Nikolaibonderup/P4---El-tek/Billeder/print.jpg

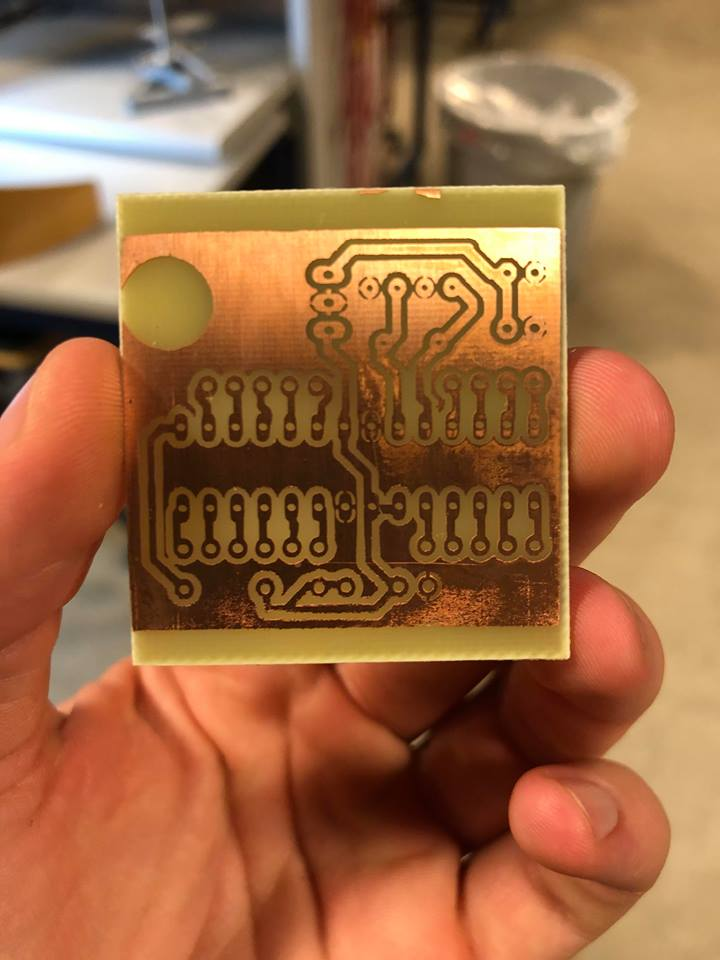
Billeder/print.jpg
