Nikolaibonderup/P4---El-tek/Billeder/printpapir.jpg

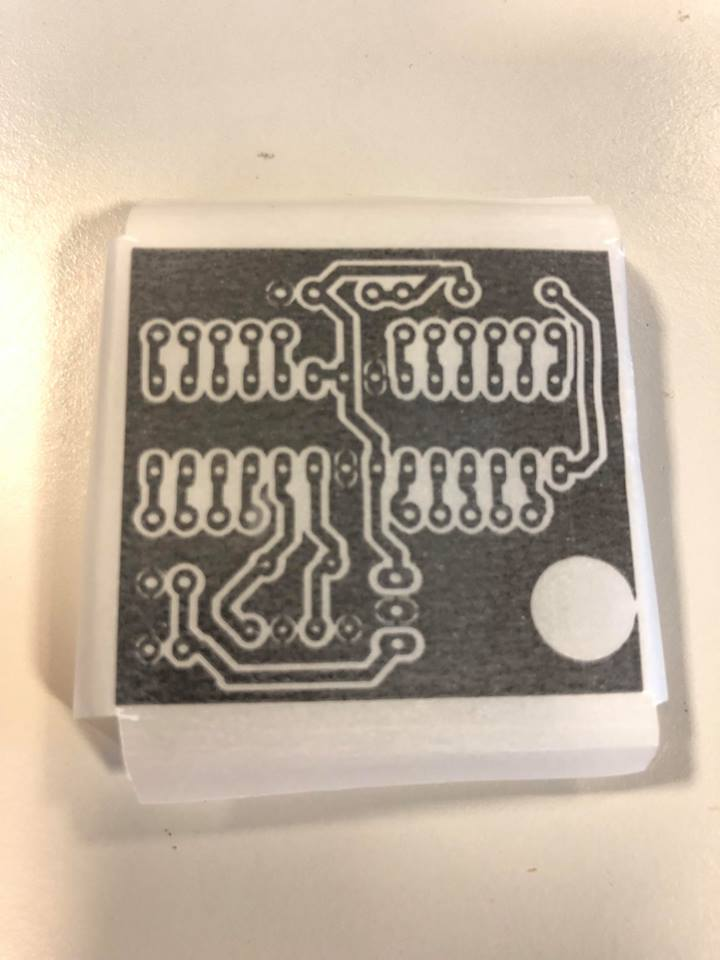
Billeder/printpapir.jpg
