Nikolaibonderup/P4---El-tek/README.md

# P4---El-tek
Projekt 4 i el teknik

#Git arkiv til p4 projekt
Dette er et git arkiv til P4---El-tek
