Nikolaibonderup/P4---El-tek/Tekst/Problemformulering.tex

%Dokument til Projektformulering
\subsection{Projektformulering}

Hvordan kan vi bygge et produkt som opfylder de faglige mål for projektet og som bygger på fysikteoretiske koncepter?\\

Til problemformuleringen kan flere underspørgsmål udformes:
\begin{itemize}
\item Hvordan kan et mikrocontroller print fabrikeres?
\item Hvordan vil man integrere datakommunikation i produktet? 
\item Hvilke former for sensorer kan bruges i løsningen og til den videnskabelige dokumentation?
\item Hvordan kan produktet bruges til at vise noget relevant fysikteori?
\end{itemize}
