Nikolaibonderup/P4---El-tek/Tekst/Bilag.tex

\section{Bilag}
\emph{Fysikrapport} af Nikolai Aaen Bonderup, Sebastian Lassen og Lucas Mark Rasmussen.\\[0.5cm]

\emph{Elektronik affald} af Nikolai Aaen Bonderup, Sebastian Lassen og Lucas Mark Rasmussen.\\[0.5cm]

\emph{Kode} af Nikolai Aaen Bonderup, Sebastian Lassen og Lucas Mark Rasmussen.\\[0.5cm]

\emph{Gruppekontrakt} af Nikolai Aaen Bonderup, Sebastian Lassen og Lucas Mark Rasmussen.\\[0.5cm]

\emph{Logbøger} af Nikolai Aaen Bonderup, Sebastian Lassen og Lucas Mark Rasmussen.\\[0.5cm]

\newpage
\input{Tekst/kode}
