Nikolaibonderup/P4---El-tek/Tekst/Forside1.tex

\begin{titlepage}

\newcommand{\HRule}{\rule{\linewidth}{0.5mm}} % Defines a new command for the horizontal lines, change thickness here

\center % Center everything on the page
 
%----------------------------------------------------------------------------------------
%	HEADING SECTIONS
%----------------------------------------------------------------------------------------

\textsc{\LARGE Aalborg Tekniske Gymnasium}\\[1.5cm] % Name of your university/college
\textsc{\Large P4 - El-Tek}\\[0.5cm] % Major heading such as course name
\textsc{\large El-teknik A}\\[0.5cm] % Minor heading such as course title

%----------------------------------------------------------------------------------------
%	TITLE SECTION
%----------------------------------------------------------------------------------------

\HRule \\[0.4cm]
{ \huge \bfseries En fjernstyret kanon  }\\[0.4cm] % Title of your document
\HRule \\[1.5cm]
 
%----------------------------------------------------------------------------------------
%	AUTHOR SECTION
%----------------------------------------------------------------------------------------

\begin{minipage}{0.4\textwidth}
\begin{flushleft} \large
\emph{Forfatter:}\\
Nikolai \textsc{Bonderup}\\ % Your name
Sebastian \textsc{Lassen}\\
Lucas \textsc{Rasmussen}
\end{flushleft}
\end{minipage}
~
\begin{minipage}{0.4\textwidth}
\begin{flushright} \large
\emph{Vejleder:} \\
Pia \textsc{Thomsen} \\ % Supervisor's Name
Tom \textsc{Berthelsen}\\
\end{flushright}
\end{minipage}\\[2cm]

% If you don't want a supervisor, uncomment the two lines below and remove the section above
%\Large \emph{Author:}\\
%John \textsc{Smith}\\[3cm] % Your name

%----------------------------------------------------------------------------------------
%	DATE SECTION
%----------------------------------------------------------------------------------------

{\large \today}\\[2cm] % Date, change the \today to a set date if you want to be precise

\vfill % Fill the rest of the page with whitespace

\end{titlepage}
