Nikolaibonderup/P4---El-tek/Tekst/Kildeliste.tex

\section{Litteraturliste}
\emph{Teknisk Matematik} af Preben Madsen, 4. Udgave. \\[0.5cm]
\emph{Orbit B} af Per Holck, Jens Kraaer og Birgitte Merci Lund. \\[0.5cm]
\url{http://www.matematikfysik.dk/fys/noter_tillaeg/tillaeg_det_skraa_kast_uden_luftmodstand.pdf} af \url{http://www.matematikfysik.dk}. Senest læst den 19/12/2018.\\[0.5cm]
\url{http://www.matematiksider.dk/projekter/skraakast.pdf} af \url{http://www.matematiksider.dk}. Senest læst den 19/12/2018
