Nikolaibonderup/P4---El-tek/FysikRapport.pdf

Aalborg Tekniske Gymnasium

Studieområde-projekt

Fysik A & el-teknik A

# En fjernstyret kanon & det skrå kast

### Forfatter: Nikolai Bonderup Sebastian Lassen Lucas Rasmussen

### Vejleder:

Pia Thomsen

Tom Berthelsen

### December 19, 2018

## Indholdsfortegnelse

1 Indledning | 2
2 Kravspecifikationer | 3
3 Projektanalyse | 4
4 Projektformulering | 5
5 Projektafgrænsning | 6
6 Tidsplan | 8
7 Systembeskrivelse | 9
8 Litteraturliste | 23

## 1 Indledning

Projektet ligger under studieområdet, hvilket her betyder at vi skal kombinere vores teknikfag med et af vores studieretningsfag. Vi har i gruppen valgt at bruge Fysik A, da dette virkede som det mest oplagte valg ift. bidragelse med projektrelevant teori. Projektet skal derfor også overholde forskellige krav fra SO, el-tek og fysik A, som bliver yderligere fremhævet i kravspecifikationen.

Vi har i gruppen besluttet os for at bygge en fjernstyret airsoft kanon, da dette produkt vil tilfredsstille alle de givne el-tek krav, samt at fysikteorien omkring det skrå kast kan bruges til at bestemme, hvor dets projektil vil ramme og hvor hurtigt det bevæger sig. Det kan gøres ved at måle, hvor langt kanonen skyder og hvilken vinkel løbet er peget op med, for så derefter at beregne mundingshastigheden vha. formler for det skrå kast. Dette kan så krydstjekkes med en målt projektilhastighed for, at opnå et fysikeksperiment udført med hjælp af elektriske komponenter.

## 2 Kravspecifikationer

De opstillede krav fra el-tek:

Der skal bruges en “interrupt” (HW - Kontakt, SW - Timer).

- Der skal altså i projektet bruges enten en kontakt eller timer i vores kredsløb. Det er påkrævet at denne har en relevant betydning for selve kredsløbet og ikke har en meningsløs funktion.

Der skal være et sensor input: analog til digital konvertering.

- Dette forstås som at der skal bruges en type sensor, som måler noget analogt, der derefter kan oversættes til noget digitalt vha. en mikroprocessor. Dette kunne for eksempel være en afstandssensor.

Digital til Analog konvertering.

- Dette vil ved brug af Arduino i de fleste tilfælde være at bruge et PWM signal til kontrol af et elektronisk element.

Der skal bruges datakommunikation (til pc, viserinstrument eller trådløst element).

- Dette ville være en form for input/output type af kontrol i forhold til vores produkt. Her skal gruppen kunne give en eller anden form for ordre til produktet og produktet skal så udføre en bestemt handling. Dette kunne opfyldes ved at styre kanonens vinkel med en controller vha. bluetooth.

Et print til en mikrocontroller.

- Der skal til produktet bruges et selvproduceret mikrocontrollerprint. Denne microcontroller skal kunne styre en af hovedelementerne i selve produktet for at opfylde kravet om at have en relevant funktion.

Udover de specifikke krav skal der også indrages relevant fysikteoretisk arbejde, som udmunder i afleveringen af videnskabelig dokumentation vedrørende det valgte fysikteori og el-tek produkt.

## 3 Projektanalyse

I dette projekt skal vi kombinere Fysik A og el-tek til et SO forløb. I projektet er der flere faglige mål som skal opfyldes indenfor området el-tek og fysik. Selve opgaven lyder på at gøre brug af de elementer som er at finde under kravspecifikationer. I problemanalysen skal disse elementer altså gennemgås og der skal vurderes, hvilket et af dem bliver det største “problem” at arbejde med.

Det mest udfordrende bliver at få skabt kommunikation mellem selve kanonen og et kontrolelement. Der skal være en modtager og afsender, måske endda en af hver på både kontrolmodul og kanon-modulet alt efter hvor avanceret arbejdet med denne del af projektet skal være.

Et andet udfordrende problem bliver, hvordan selve lade- og affyringsmekanismen skal hænge sammen så den kan virke ved fjernstyring. Her skal flere forskellige typer motorer styres præcist gennem bluetooth.

## 4 Projektformulering

Hvordan kan vi bygge et produkt som opfylder de faglige mål for projektet og som bygger på fysikteoretiske koncepter?

Til problemformuleringen kan flere underspørgsmål udformes:

- Hvordan kan et mikrocontroller print fabrikeres?
- Hvordan vil man integrere datakommunikation i produktet?
- Hvilke former for sensorer kan bruges i løsningen og til den videnskabelige dokumentation?
- Hvordan kan produktet bruges til at vise noget relevant fysikteori?

## 5 Projektafgrænsning

Vi har planlagt at arbejde med en kanon som skal kunne rotere 360 grader, samt have et vinkelinterval til affyring af kanonen på mindst 100 grader. Den fjernstyrede kanon skal være i stand til at modtage information fra et kontrolmodul. Dette skal ske ved brug af en bluetooth enhed eller et andet trådløst kommunikationsmodul. Der skal altså laves en mikrocontroller som kan styre kanonen gennem disse trådløse moduler ved at få kommandoer fra et kontrolmodul.

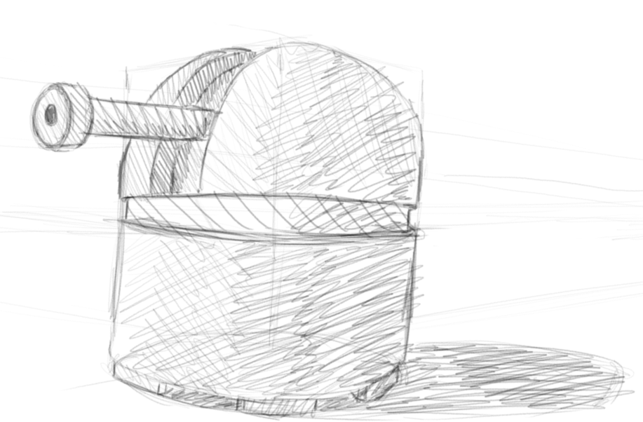
[picture p3: figure]

Fig. 1: Koncept af kanon.

Selve kanons affyringsmekanisme laves enten med en “airsoft” pneumatisk gearkasse, hvor en DC motor bruges til at trække en fjeder op. Denne fjeder laver et lufttryk i gearkassens trykkammer som kan bruges til at skyde et projektil afsted. Selve robottens krop laves vha. 3D print af de enkelte komponenter, der sættes sammen med enten lim eller skruer.

Til udarbejdningen af det fysikvidenskabelige dokumentation kan der påmonteres forskellige accelerometerer, som kan bruges til at bestemme skydevinklen. Derudover kan der alternativt måles, hvor langt projektilet bliver affyret for så, at kunne beregne dets hastighed, hvis affyringsvinklen er kendt.

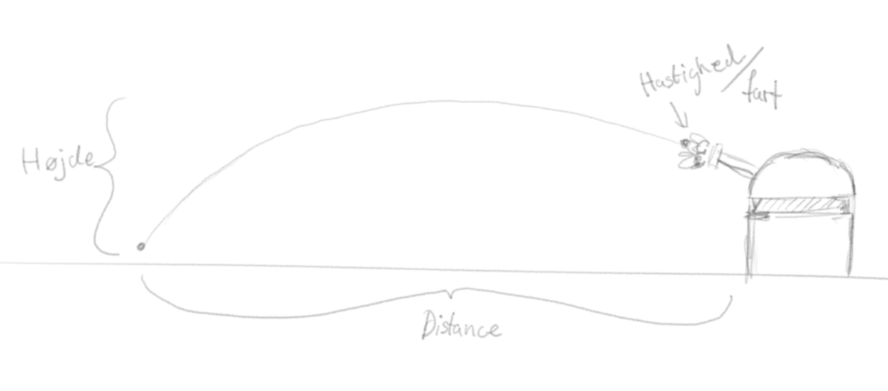
[picture p4: figure]

Fig. 2: Fysik relevant til kanonen.

## 6 Tidsplan

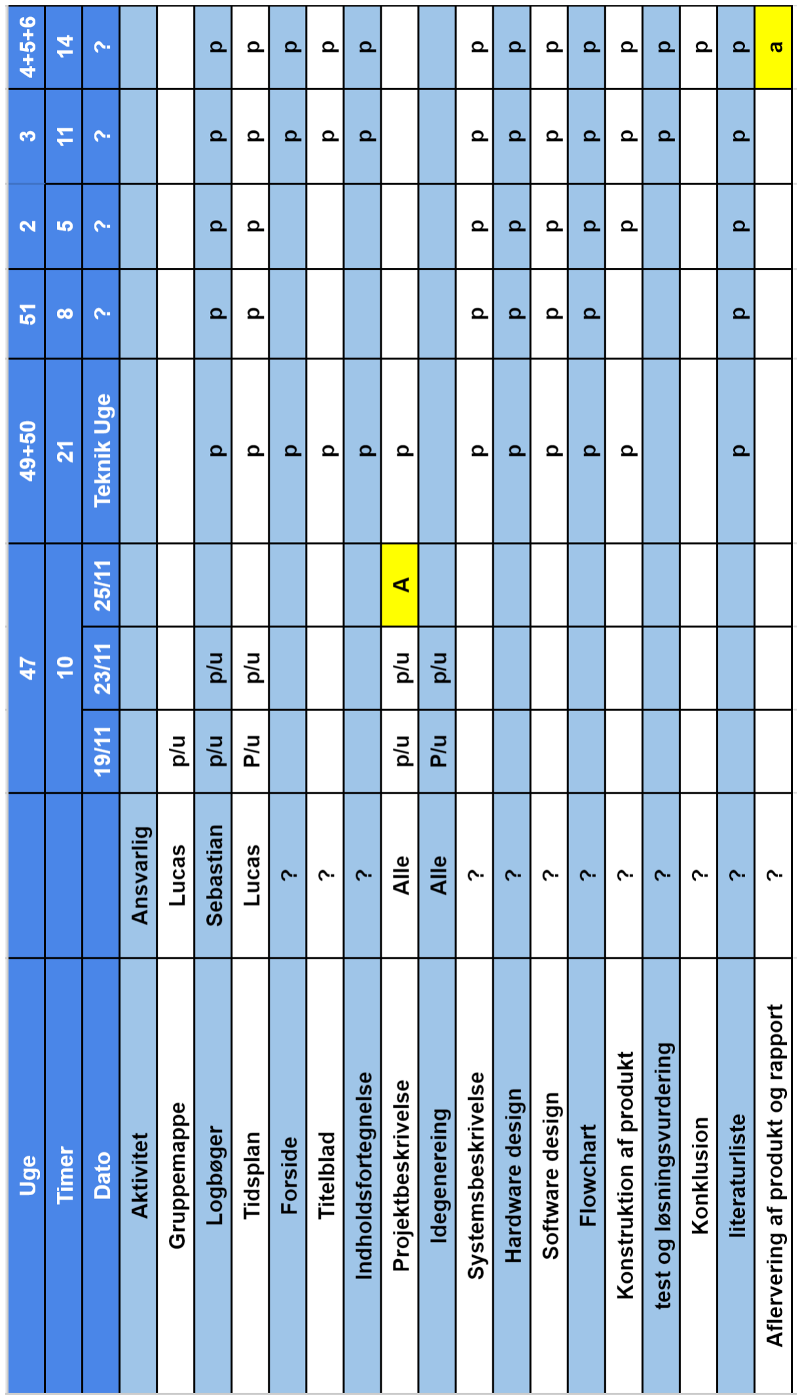
[picture p5: figure]

Fig. 3: Første udkast af en tidsplan.

## 7 Systembeskrivelse

### 7.1 Fysik teori

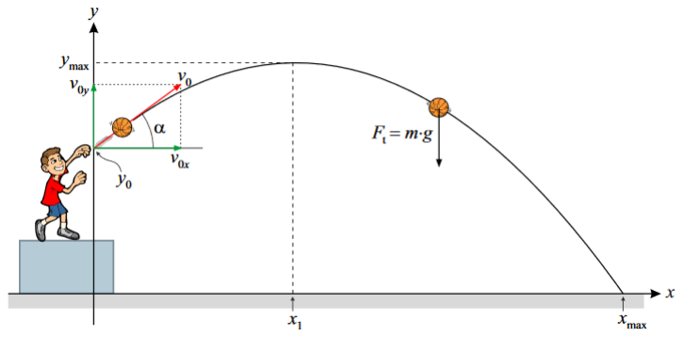
[picture p6: figure]

Fig. 4: Skitse af det skraa kast. Figuren stammer fra http://www.matematikfysik.dk/fys/noter_tillaeg/tillaeg_det_skraa_kast_uden_luftmodstand.pdf (http://www.matematikfysik.dk/fys/noter_tillaeg/tillaeg_det_skraa_kast_uden_luftmodstand.pdf)

Teoretisk udledning af formler til det skrå kast
Begyndelseshastigheden for et kast er givet ud fra vektoren v0 og vinklen a, det betyder altså at hastighedsvektorens komposanter kan findes ved:

vx = v0 · cos(a) og vy = v0 · sin(a)

Samtidigt vides det at x- og y-slut kan skrives som to bevægelsesligninger:

y = −

1
2
- g · t

2 + vy · t + y0

Hvor dette er formlen for strækning inden for faget kinematik, omskrevet til at passe på y-aksen i det skrå kast. Her skiftes strækningen ud med y og accelerationen med g, da det er tyngdeaccelerationen som kastet arbejder imod:

s = −

1
2
- g · t

2 + v0 · t + s0

x er derved givet ved konstant hastighed, denne får altså ligningen:

x = vx · t

Hvor denne er omskrevet fra formlen for konstant hastighed:

v =

∆s
∆t
Hvor der isoleres for strækningen:

v =

∆s
∆t

−→ ∆s = v · δt

Dette giver altså to ligninger for x- og y-slut nr komposanterne indsættes:

xslut = v0 · cos(a) · t

og

yslut = −

1
2
- g · t

2 + v0 · sin(a) · t + y0

Bestemmelse af xslut
I vores forsøg kender vi hverken tiden eller xslut. Tiden kan dog bestemmes.

Det vides at yslut er lig y0, da planet forsøget er udført på er ensartet, dette vil altså sige, at både yo og yslut er lig 0. Dette kan altså sættes ind i ligningen for yslut og der kan isoleres for t:

0 = −

1
2
- g · t

2 + vy · t + y0 −→ t =

vy +

p
2 · g · y0 + y

2
y
g
Den tidligere bestemte y komposant kan indsættes så alle variabler kendes:

t =

v0 · sin(a) + p
2 · g · y0 + y

2
y
g
Opsat som vektorfunktion
Vektorfunktioner er givet ud fra en ligning for bevægelsen på x-aksen og bevægelsen på y-aksen:
−→r (t) =
x(t)
y(t)

Da bevægelser er beskrevet ved brug af vektorere opsættes skuddet som en vektorfunktion:

−→r (t) =

v0 · cos(a) · t

−

1
2
- g · t

2 + v0 · sin(a) · t + y0

!

### 7.2 Forsøg

### 7.2.1 Apparaturliste

- 2x opsætnings stativer
- 1x BT5 A5 Elektrisk Airsoft Gevær
- 1x LiDAR af typen Leica “Disto D5”
- 1x Tomstok

### 7.2.2 Fremgangsmåde

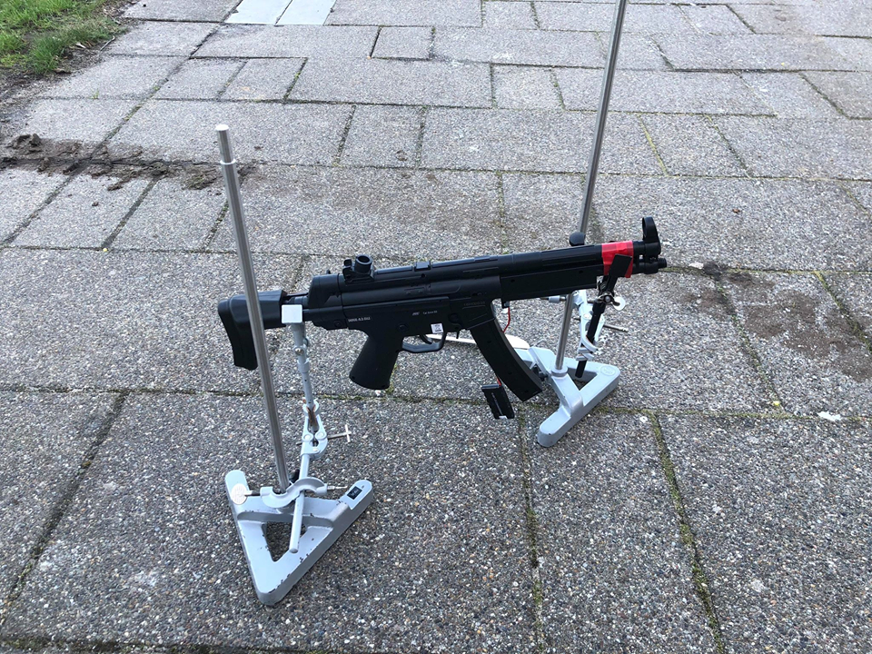
[picture p7: figure]

Fig. 5: Forsogsopstilling.

1. Først opsættes det elektriske airsoft gevær på en sådan måde at vinklen er let at ændre, denne opsætning ses på figur 5.
2. Der indstilles en vinkel.
(a) Højden mellem de to monteringspunkter og jorden måles.
(b) Der måles en afstand mellem de to monteringspunkter, dette er en hypotenuse mellem de to monteringspunkter.

(c) det lave monteringspunkt trækkes fra det høje, og nu er en modstående katete til den ønskede vinkel fundet.
(d) Bestem brugt vinkel ud fra sinus beregning.
3. Skud affyres.
4. Afstanden fra skuddets første kontaktpunkt med jorden hen til gevær-opstillingen ved hjælp af LiDAR.
5. Der tages tre målinger for hver vinkel.

### 7.2.3 Resultatbehandling

For at undersøge hypotesen om, hvorvidt det skrå kast er en god model til at beskrive airsoft-geværets skud vil vi sammenligne de teoretiske beregninger med det målte data. Til at gøre dette har vi sammenlignet den teoretisk beregnede xslut med den gennemsnitlige målte xslut (x1, x2 osv.) for hver vinkel vi har udført målinger med. Den grønne kurve og det sorte punkt er de teoretiske værdier, mens de blå punkter er det målte data.

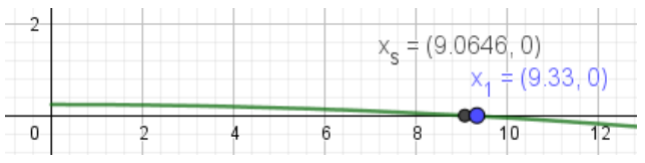
[picture p8: figure]

Fig. 6: Korsel 1. Vandret skudvinkel, haevet 0,23 m.

Som det kan ses på figur 6 skyder geværet meget tæt på den teoretiske længde når skudvinklen er vandret. Det betyder at den kendte funktion for det skrå kast uden luftmodstand er en god model til at beskrive skud med denne vinkel, da den ville kunne ramme en skive på størrelse med et menneske, hvis den er indstillet vha. den teoretiske kurve.

Fig. 7: Korsel 2. Skudvinkel på 5 grader, haevet 0,27 m.

Som det kan ses på figur 7 burde skuddet flyve mere end tredobbelt så langt som før ved denne vinkel, men at dette ikke sker i praksis. For at konstruere en mere beskrivende kurve for skuddet ved 5 grader, kan man modificere kurven for det skrå kast ved at omskrive y(t)-leddet så den hælder dobbelt så meget.

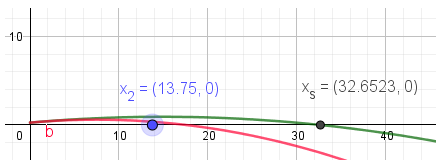
[picture p9: figure]

Fig. 8: Korsel 2. Den rode linje angiver den modificerede kurve.

−→r (t) =

v0 · cos(a) · t

−

1
2
- g · t

2 + v0 · sin(a) · t + y0

!

−→r (t) =

v0 · cos(a) · t

−

1
2
- g · t

2 + v0 · sin(a) · t + y0

!

−→r (t) =
v0 · cos(a) · t
−1 · g · t

2 + v0 · sin(a) · t + y0

Som det kan ses på figur 8 får kurven en dobbelt så stor hældning ved at multiplikere

y(t)-leddet med 2, så −

1
2

bliver til −1.

Fig. 9: Korsel 3. Skudvinkel på 10 grader, haevet 0,31 m

Igen viser figur 9 at den teoretiske værdi er mange gange større end den praktiske. Denne gang viser kurven at skuddet burde flyve mere end tredobbelt så langt som tidligere, hvilket peger i retning af at som skudvinklen bliver større, og dermed også længden af skuddets bane, bliver den praktiske skudlængde eksponentielt mindre sammenlignet med den teoretiske.

Ud fra det kan vi opstille en mere generel kurve til vores skud, som inkorporerer en stigende hældning i takt med at skudvinklen stiger. Dette kan gøres ved at observere, hvordan den teoretiske værdi svinger mere fra den praktiske jo større skudvinklen er.

- For 0 grader: xteori = 1xpraktisk
- For 5 grader: xteori = 2xpraktisk
- For 10 grader: xteori = 3xpraktisk

- For 15 grader: xteori = 4xpraktisk

Hvis antallet af grader byttes ud med et symbol, kan en generel sammenhæng findes.

For n grader: xteori ≈ ((n
5

) + 1)

For at opsætte en kurve som følger dette princip, kan vi modificere x(t) så kurvens hældning bliver kraftigere i takt med at skudvinklen stiger.

x(t) = v0 · cos(a) · t

x(t) = v0 · cos(a) · t
a
5

+ 1

Fig. 10: Den nye funktions slutpunkt sammenlignet med maalepunktet ved 5 grader.

Som det kan ses på figur 10 er der stadig en forskel på ca. 2,5 meter mellem de to nedslagspunkter. Denne forskel kan kraftigt formindskes ved at lægge 1,5 til i stedet for 1 i x(t).

x(t) = v0 · cos(a) · t
a
5

+ 1.5

For at undersøge om den nye kurve beskriver skuddene på > 5 grader mere præcist, kan vi sammenligne dens slutpunkt med målepunkterne. Noter at xT er det nedslagspunkt kurven forudsiger, hvorimod x2, x3 etc. er målepunkter.

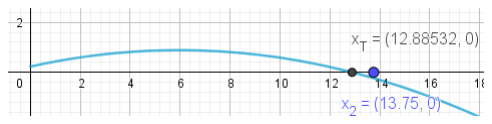
[picture p10: figure]

Fig. 11: Den nye kurve og maalepunktet til 5 grader.

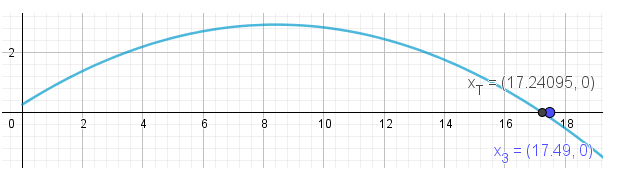
[picture p11: figure]

Fig. 12: Den nye kurve og maalepunktet til 10,15 grader.

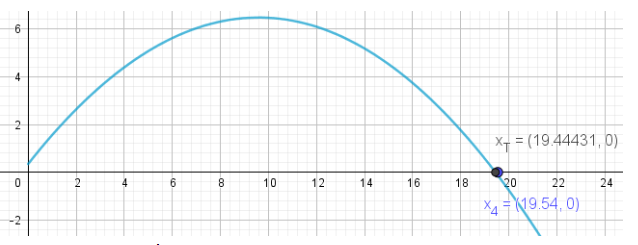
[picture p12: figure]

Fig. 13: Den nye kurve og maalepunktet til 15,53 grader.

Som det kan ses på figur 11 , 12 og 13 passer den nye kurve og dens nedslagspunkt meget præcist på det beregnede. Modellen beskriver altså, hvordan vores airsoft-gevær skyder meget mere præcist end det skrå kast, da denne tager hensyn til vinklen samt konstanten 1,5, der bliver lagt til. Konstanten og hensynet til vinklen bruges altså til at tage luftmodstanden med i beregningen, da denne er forskellen på forsøgsdataet og det skrå kasts teoretiske beregninger.

Kurven til vores airsoft-geværs skud bliver altså beskrevet ved:

−→r (t) =
x(t)
y(t)
=

v0 · cos(a) · t
a
5

+ 1.5

−

1
2
- g · t

2 + v0 · sin(a) · t + y0

### 7.2.4 Diskussion

Mange faktorer har haft en indflydelse på indsamlingen af måledata til dette forsøg. Først og fremmest var det nødvendigt at lave forsøget udenfor, da geværet både skyder langt og højt. Dette skaber problemer i forhold til vind, da kuglerne er meget lettere. Dette kan blandt andet være grunden til at de længere skud har større variation i hvor de lander, da de har haft længere tid til at blive påvirket af eventuelle vindstød.

Samtidigt var det svært at se præcis hvor kuglerne landede da de er små og flyver relativt hurtigt. (Mundingshastigheden er cirka 41 m/s og kuglernes diameter er 6 mm). Dette problem løste vi dog ved at bruge en sandkasse. Her hoppede kuglerne nemlig sjældent efter de ramte jorden og blev som regel liggende hvor de ramte. Dette gjorde selve måle-arbejdet betydeligt meget lettere.

Inden vi opsatte vores egen vektorfunktion som model til skuddene, afprøvede vi en anden kendt model for det skrå kast med luftmodstand¹

−→r (t) =
x(t)
y(t)
=

v0 · cos(a) · t
a
5

+ 1.5

−

1
2
- g · t

2 + v0 · sin(a) · t + y0

Vi fandt dog hurtigt ud af at denne kun er egnet når man arbejder med objekter, der enten er meget tungere eller bevæger sig markant langsommere, da den overestimerer luftmodstanden så meget ved vores skud, at nedslagspunktet ligger indenfor de første 0,5 meter ved alle vinkler.

1http://www.matematiksider.dk/projekter/skraakast.pdf

### 7.3 Elektriske kredsløb

I dette projekt er der i alt 2 forskellige elektriske kredsløb ( hvis man ignorere de isoleret kredsløb, som bliver skabt pga. Brugen af H-broer og hardball pistol). Kredsløb #1 er kredsløbet som kan findes på selve kanon. Dette kredsløb styrer kanonens bevægelse vha. Motorer og sensorer. Kredsløb #2 er kredsløbet som findes på kontrolleren. Dette kredsløb bruges til at styrer kanonen gennem et bluetooth signal fra kredsløb #2 til kredsløb #1.

Kredsløb #1

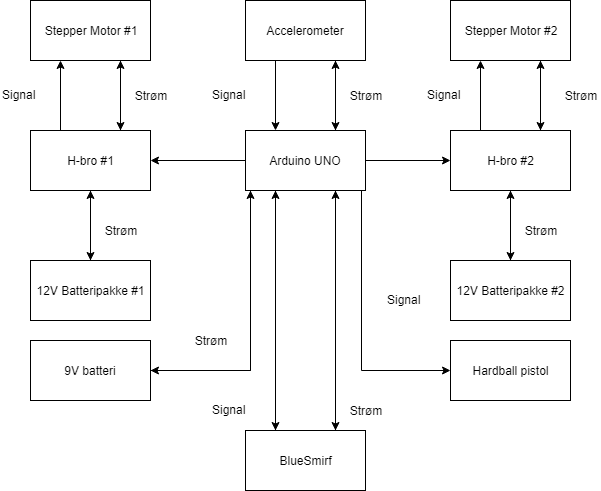
[picture p13: figure]

Fig. 14: Blokdiagram af kredsløb #1.

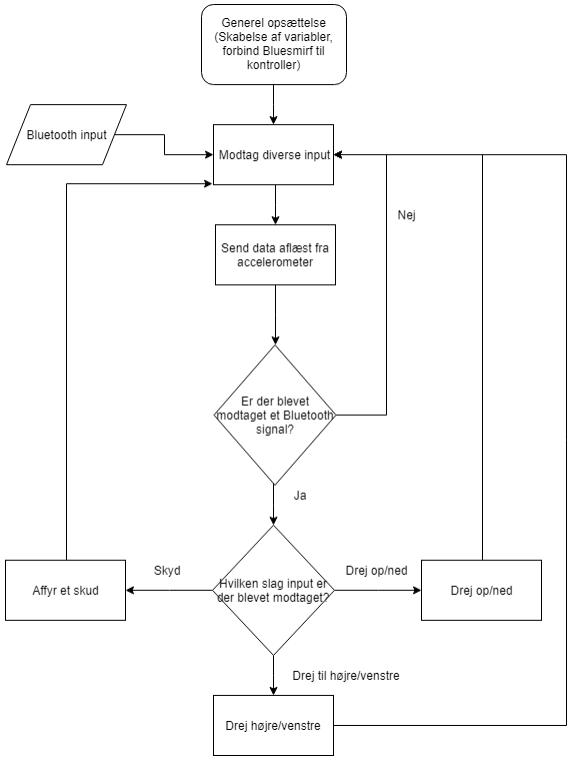
[picture p14: figure]

Fig. 15: Flowdiagram af kredsløb #1.

Systemdele

- Arduino UNO

– På blokdiagrammet (Fig. 14) kan det ses, at Arduinonen er forbundet til næsten alle elektroniske elementer i robotten.

- 9V batteri

– Dette 9 volts batteri fungere som Arduinoens strømforsyning.

- 12V batteripakke #1

– Denne batteripakke fungere som stepper motor #1’s strømforsyning.

- 12V batteripakke #2

– Denne batteripakke fungere som stepper motor #2’s strømforsyning.

- H-bro ( LN298 ) #1

– H-bro #1 er forbundet til stepper motor #1 og 12V batteripakke #1. Derudover bliver H-broen kontrolleret af en Arduino, som ikke er i kredsløb med batteripakke #1.

- H-bro ( LN298 ) #2

– H-bro #2 er forbundet til stepper motor #2 og 12V batteripakke #2. Derudover bliver H-broen kontrolleret af en Arduino, som ikke er i kredsløb med batteripakke #2.

- Stepper Motor #1

– Stepper #1 er forbundet til 12V batteripakke #1 via. H-bro #1. Derudover er stepper motoren kontrolleret af H-bro #1.

- Stepper Motor #2

– Stepper #2 er forbundet til 12V batteripakke #2 via. H-bro #2. Derudover er stepper motoren kontrolleret af H-bro #2

- Accelerometer

– Accelerometeret er forbundet til Arduinoen, som den desuden også modtager strøm fra.

- Hardball pistol

– Hardball pistolen indgår også i det elektriske kredsløb. Hardball pistolens skyde mekanism bliver kontrolleret af Arduinoen. I selve hardball pistolen findes der også et elektrisk kredsløb, dog er delene til dette kredsløb ikke beskrevet i blokdiagrammet, da det ikke er et selv fabrikeret elektrisk komponent.

- BlueSmirf

– BlueSmirf modulet modtager strøm fra Arduinoen. Derudover kommunikere BlueSmirf modulet med Arduinoen.

Kredsløb #2

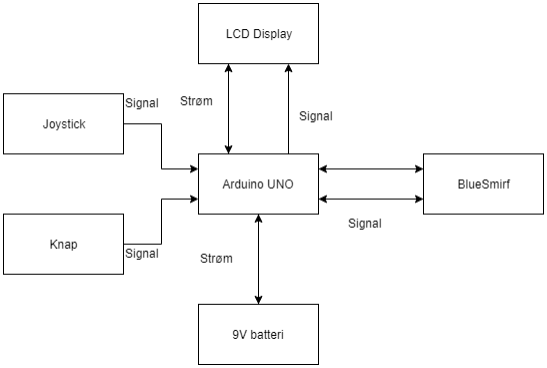
[picture p15: figure]

Fig. 16: Blokdiagram af kredsløb #2.

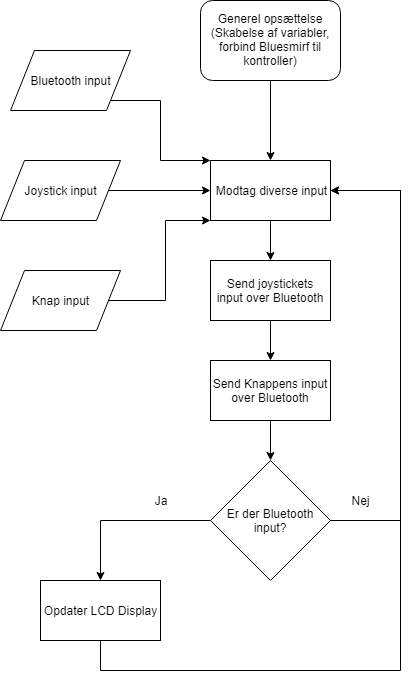
[picture p16: figure]

Fig. 17: Flowdiagram af kredsløb #2.

Systemdele

- Arduino UNO

– På blokdiagrammet (Fig. 16) kan det ses, at Arduinonen er forbundet til alle elektroniske elementer.

- 9V batteri

– Dette 9 volts batteri fungere som Arduinoens strømforsyning.

- Joystick

– Joysticket er forbundet til Arduinoen, som måler strømmen der løber gennem joysticket.

- Knap

– Knappen er forbundet til Arduinoen, som måler strømmen der løber gennem knappen.

- BlueSmirf

– BlueSmirf modulet modtager strøm fra Arduinoen. Derudover kommunikere BlueSmirf modulet med Arduinoen.

- LCD Display

– LCD Display modulet er forbundet til Arduinoen og modtager også strøm fra Arduinoen.

## 8 Litteraturliste

Teknisk Matematik af Preben Madsen, 4. Udgave.

Orbit B af Per Holck, Jens Kraaer og Birgitte Merci Lund.

http://www.matematikfysik.dk/fys/noter_tillaeg/tillaeg_det_skraa_kast_uden_luftmodstand.pdf (http://www.matematikfysik.dk/fys/noter_tillaeg/tillaeg_det_skraa_kast_uden_luftmodstand.pdf) af http://www.matematikfysik.dk. Senest læst den 19/12/2018.

http://www.matematiksider.dk/projekter/skraakast.pdf af http://www.matematiksider. dk. (http://www.matematiksider.dk) Senest læst den 19/12/2018

## Bilag

### Måldata

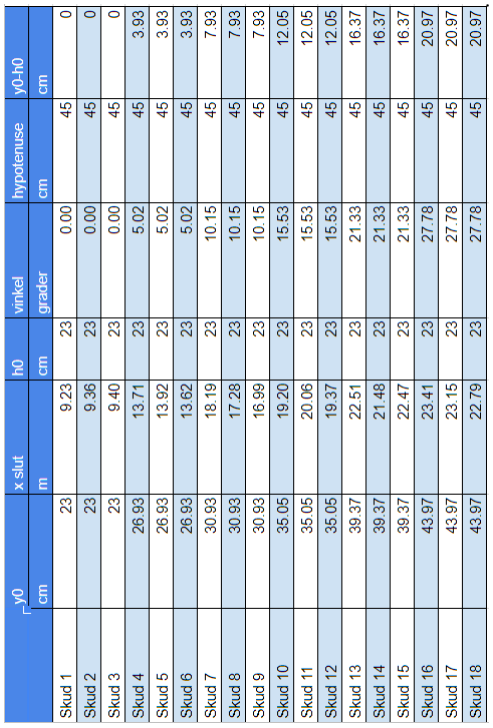
[picture p17: figure]

Fig. 18: Maldata.
