Nikolaibonderup/P4---El-tek/Rapport.pdf

Aalborg Tekniske Gymnasium

P4 - El-Tek

El-teknik A

# En fjernstyret kanon

### Forfatter: Nikolai Bonderup Sebastian Lassen Lucas Rasmussen

### Vejleder:

Pia Thomsen

Tom Berthelsen

### February 6, 2019

## Titelblad

Projekttitel Sensorer og datakommunikation

Uddannelsessted og klasse Aalborg tekniske Gymnasium, Q16

Fag Teknikfag, Elektronik A

Projektperiode x/x/2018 - 6/2/2019

### Projektet udarbejdet af:

Lucas Mark Rasmussen

Sebastian Lassen

Nikolai Aaen Bonderup

### Synopsis

I dette projekt har vi fået til opgave at lave et produkt, som skal kunne opfylde nogle praktiske krav, der er givet ved en opgaveformulering og produktkrav. Der er blevet udleveret flere forskellige bluetooth elementer, hvorefter gruppen selv har skulle idegenerere og konstruere et produkt som lever op til de krav, som er stillet i selve opgaveformuleringen (kravspecifikationen). Projektet har derfor resulteret i et kanontårn som kan kontrolleres trådløst og er i besiddelse af en form for interrupt, forskellige slags motorer og et mikrocontrollerprint.

### Forord

Rapporten består af otte hovedafsnit som er markeret i indholdsfortegnelsen og seks, hvis litteraturliste og bilag trækkes fra. Disse hovedafsnit har hver en mængde af underafsnit som også kan ses i selve indholdsfortegnelse. I afsnittene gennemgås arbejdet med robotten og overvejelser som gruppen har gjort sig. Der medfølger selvfølgelig billede af udvalgte dele af arbejdet, samt tekniske tegninger og i nogle tilfælde også tidligere versioner af disse tegninger for at vise en udvikling.

## Indholdsfortegnelse

1 Indledning | 5
2 Projektbeskrivelse | 6
3 Systembeskrivelse | 13
4 Hardware | 21
5 Software | 29
6 Ikke elektroniske dele | 34

7 Aftestning | 37
8 Konklusion | 44
9 Litteraturliste | 45
10 Bilag | 46

## 1 Indledning

Projektet ligger under studieområdet, hvilket her betyder at vi skal kombinere vores teknikfag med et af vores studieretningsfag. Vi har i gruppen valgt at bruge Fysik A, da dette virkede som det mest oplagte valg ift. bidragelse med projektrelevant teori. Projektet skal derfor også overholde forskellige krav fra SO, el-tek og fysik A, som bliver yderligere fremhævet i kravspecifikationen.

Vi har i gruppen besluttet os for at bygge en fjernstyret airsoft kanon, da dette produkt vil tilfredsstille alle de givne el-tek krav, samt at fysikteorien omkring det skrå kast kan bruges til at bestemme, hvor dets projektil vil ramme og hvor hurtigt det bevæger sig. Det kan gøres ved at måle, hvor langt kanonen skyder og hvilken vinkel løbet er peget op med, for så derefter at beregne mundingshastigheden vha. formler for det skrå kast. Dette kan så krydstjekkes med en målt projektilhastighed for, at opnå et fysikeksperiment udført med hjælp af elektriske komponenter.

## 2 Projektbeskrivelse

### 2.1 Projektanalyse

I dette projekt skal vi kombinere Fysik A og el-tek til et SO forløb. I projektet er der flere faglige mål som skal opfyldes indenfor området el-tek og fysik. Selve opgaven lyder på at gøre brug af de elementer som er at finde under kravspecifikationer. I problemanalysen skal disse elementer altså gennemgås og der skal vurderes, hvilket et af dem bliver det største “problem” at arbejde med.

Det mest udfordrende bliver at få skabt kommunikation mellem selve kanonen og et kontrolelement. Der skal være en modtager og afsender, måske endda en af hver på både kontrolmodul og kanon-modulet alt efter hvor avanceret arbejdet med denne del af projektet skal være.

Et andet udfordrende problem bliver, hvordan selve lade- og affyringsmekanismen skal hænge sammen så den kan virke ved fjernstyring. Her skal flere forskellige typer motorer styres præcist gennem bluetooth.

### 2.2 Projektformulering

Hvordan kan vi bygge et produkt som opfylder de faglige mål for projektet og som bygger på fysikteoretiske koncepter?

Til problemformuleringen kan flere underspørgsmål udformes:

- Hvordan kan et mikrocontroller print fabrikeres?
- Hvordan vil man integrere datakommunikation i produktet?
- Hvilke former for sensorer kan bruges i løsningen og til den videnskabelige dokumentation?
- Hvordan kan produktet bruges til at vise noget relevant fysikteori?

### 2.3 Projektafgrænsning

Vi har planlagt at arbejde med en kanon som skal kunne rotere 360 grader, samt have et vinkelinterval til affyring af kanonen på mindst 100 grader. Den fjernstyrede kanon skal være i stand til at modtage information fra et kontrolmodul. Dette skal ske ved brug af en bluetooth enhed eller et andet trådløst kommunikationsmodul. Der skal altså laves en mikrocontroller som kan styre kanonen gennem disse trådløse moduler ved at få kommandoer fra et kontrolmodul.


Fig. 1: Koncept af kanon.

Selve kanons affyringsmekanisme laves enten med en “airsoft” pneumatisk gearkasse, hvor en DC motor bruges til at trække en fjeder op. Denne fjeder laver et lufttryk i gearkassens trykkammer som kan bruges til at skyde et projektil afsted. Selve robottens krop laves vha. 3D print af de enkelte komponenter, der sættes sammen med enten lim eller skruer.

Til udarbejdningen af det fysikvidenskabelige dokumentation kan der påmonteres forskellige accelerometerer, som kan bruges til at bestemme skydevinklen. Derudover kan der alternativt måles, hvor langt projektilet bliver affyret for så, at kunne beregne dets hastighed, hvis affyringsvinklen er kendt.


Fig. 2: Fysik relevant til kanonen.

### 2.4 Kravspecifikationer

De opstillede krav fra el-tek:

Der skal bruges en “interrupt” (HW - Kontakt, SW - Timer).

- Der skal altså i projektet bruges enten en kontakt eller timer i vores kredsløb. Det er påkrævet at denne har en relevant betydning for selve kredsløbet og ikke har en meningsløs funktion.

Der skal være et sensor input: analog til digital konvertering.

- Dette forstås som at der skal bruges en type sensor, som måler noget analogt, der derefter kan oversættes til noget digitalt vha. en mikroprocessor. Dette kunne for eksempel være en afstandssensor.

Digital til Analog konvertering.

- Dette vil ved brug af Arduino i de fleste tilfælde være at bruge et PWM signal til kontrol af et elektronisk element.

Der skal bruges datakommunikation (til pc, viserinstrument eller trådløst element).

- Dette ville være en form for input/output type af kontrol i forhold til vores produkt. Her skal gruppen kunne give en eller anden form for ordre til produktet og produktet skal så udføre en bestemt handling. Dette kunne opfyldes ved at styre kanonens vinkel med en controller vha. bluetooth.

Et print til en mikrocontroller.

- Der skal til produktet bruges et selvproduceret mikrocontrollerprint. Denne microcontroller skal kunne styre en af hovedelementerne i selve produktet for at opfylde kravet om at have en relevant funktion.

Udover de specifikke krav skal der også indrages relevant fysikteoretisk arbejde, som udmunder i afleveringen af videnskabelig dokumentation vedrørende det valgte fysikteori og el-tek produkt.

### 2.5 Tidsplan

I dette projekt har vi fået en bestemt mængde af tid med vejledning på. Der er så senere på grund af mangel på tid brugt timer i værkstedet uden vejledning hvor gruppen helt selvstændigt har arbejdet med produktudvikling. Herunder ses en tegnforklaring til opsætningen af de viste tidsplaner.

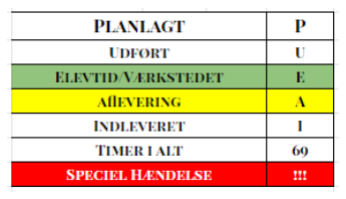
[picture p18: figure]

Fig. 3: Symboler som fremkommer i tidsplanen.

- “Planlagt” bliver sat på de felter hvor en opgave er planlagt.
- “Udført” sættes i alle de felter hvor en opgave er løst, ligegyldigt om det var planlagt.
- “Elevtid/Værksted” er timer som ikke er skemalagte, men hvor gruppen stadig har arbejdet i el-værkstedet.
- “Aflevering” er sat på de datoer hvor et stykke arbejde skal afleveres. Et “afleveringsfelt” markeres med “Indleveret” for at vise at en aflevering er blevet indleveret.

I bunden er de tiltænkte timer indskrevet som skal bruges på projektet. Herunder ses “Speciel Hændelse” som er markeret på tidsplanerne, hvis sådanne finder sted.

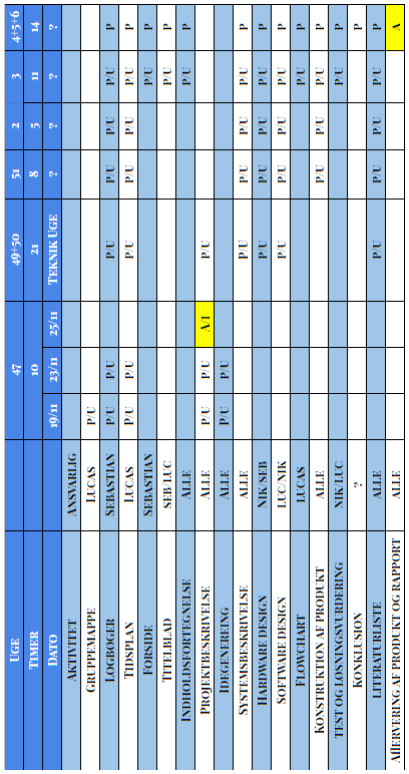
[picture p19: figure]

Fig. 4: Endelige udkast af tidsplanen.

## 3 Systembeskrivelse

Afsnitet systembeskrivelse beskriver de forskellige elektroniske komponenters relation til hinanden via.Til hvert elektriske kredsløb er der et blokdiagram og en uddybende forklaring af blokdiagrammets elementer. Derudover er der et flowdiagram som viser det elektriske kredsløbs funktion.

I dette projekt er der i alt 2 forskellige elektriske kredsløb ( hvis man ignorere de isoleret kredsløb, som bliver skabt pga. Brugen af H-broer og hardball pistol). Kredsløb #1 er kredsløbet som kan findes på selve kanon. Dette kredsløb styrer kanonens bevægelse vha. Motorer og sensorer. Kredsløb #2 er kredsløbet som findes på kontrolleren. Dette kredsløb bruges til at styrer kanonen gennem et bluetooth signal fra kredsløb #2 til kredsløb #1.

### 3.1 Kanontårn

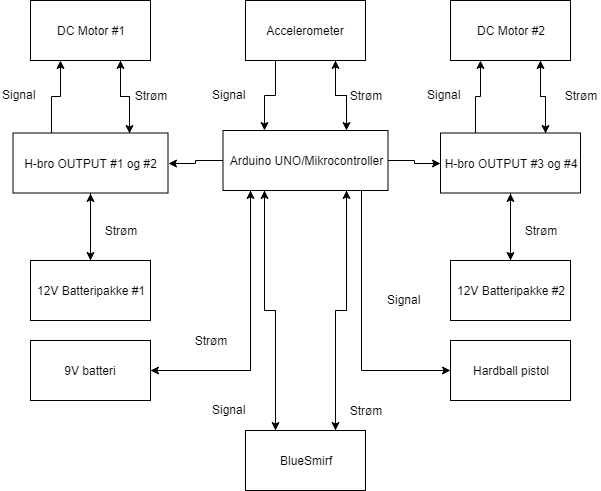
[picture p20: figure]

Fig. 5: Blokdiagram af kanontaarnets elektriske kredslob.

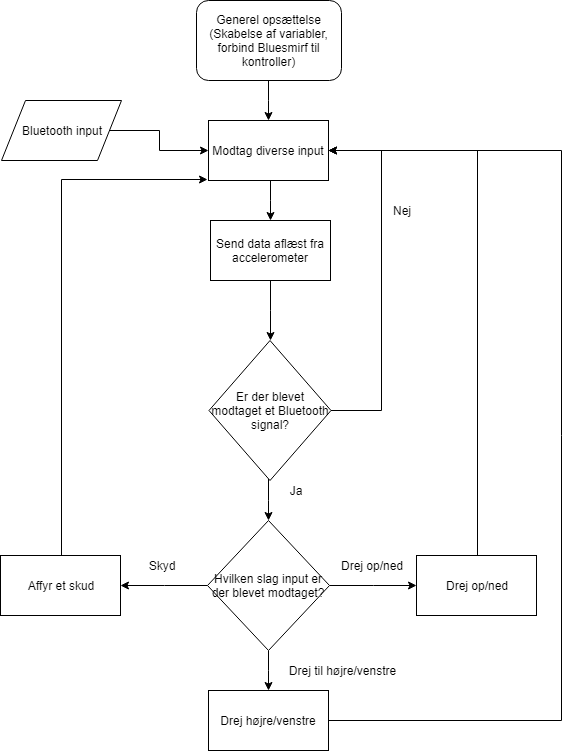
[picture p21: figure]

Fig. 6: Flowdiagram af kanontaarnets funktion.

Systemdele

- Arduino UNO / Mikrocontroller

– På blokdiagrammet kan det ses, at Arduinoen er forbundet til næsten alle elektroniske elementer i kanontårnet. I arduinoens sted kan gruppens egen mikrocontroller print også monteres, da den har samme funktionalitet.

- 9V batteri

– Dette 9 volts batteri fungere som Arduinoens / mikrocontrollerens strømforsyning.

- 6V batteripakke #1

– Denne batteripakke fungere som motor #1’s strømforsyning.

- 6V batteripakke #2

– Denne batteripakke fungere som motor #2’s strømforsyning.

- H-bro ( LN298 ) #1

– H-bro #1 er forbundet til motor #1, 6V batteripakke #1 og 6V batteripakke #2. Derudover bliver H-broen kontrolleret af en Arduino, som ikke er i kredsløb med batteripakke #1 og #2.

- Motor #1

– Motor #1 er forbundet til 6V batteripakke #1 via. H-bro #1. Derudover er motoren kontrolleret af H-bro #1.

- Stepper Motor #2

– Motor #2 er forbundet til 6V batteripakke #2 via. H-bro #1. Derudover er stepper motoren kontrolleret af H-bro #1.

- Accelerometer

– Accelerometeret er forbundet til Arduinoen, som den desuden også modtager strøm fra.

- Hardball pistol

– Hardball pistolen indgår også i det elektriske kredsløb. Hardball pistolens skyde mekanism bliver kontrolleret af Arduinoen. I selve hardball pistolen findes der også et elektrisk kredsløb, dog er delene til dette kredsløb ikke beskrevet i blokdiagrammet, da det ikke er et selv fabrikeret elektrisk komponent.

- BlueSmirf

– BlueSMiRF komponenten “Silver mate” er forbundet til Arduinoen. BlueSMiRF’en sender og modtager signaler fra Arduinoen. Arduinoen fungerer som strømforsyning til BlueSMiRF’en.

### 3.2 Controller

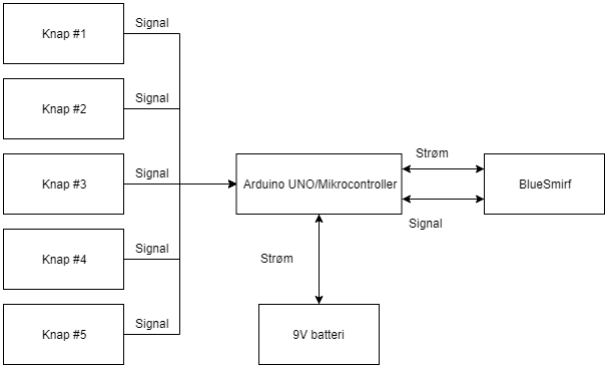
[picture p22: figure]

Fig. 7: Blokdiagram af controllerens elektriske kredslob.

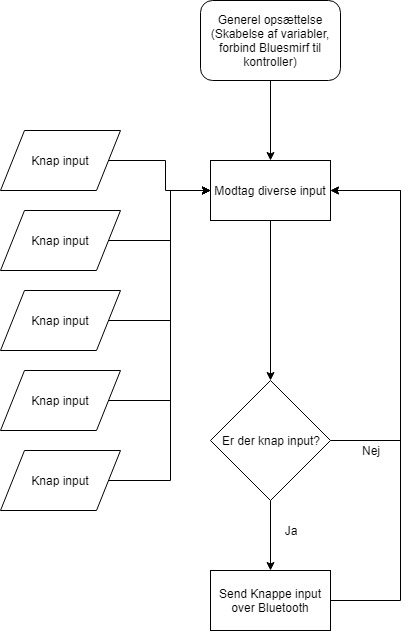
[picture p23: figure]

Fig. 8: Flowdiagram af controllerens funktion.

Systemdele

- Arduino UNO / Mikrocontroller

– På blokdiagrammet kan det ses, at Arduinoen er forbundet til næsten alle elektroniske elementer i kanontårnet. I arduinoens sted kan gruppens egen mikrocontroller print også monteres, da den har samme funktionalitet.

- 9V batteri

– Dette 9 volts batteri fungere som Arduinoens strømforsyning.

- Knap #1

– Denne knap sender et signal til Arduinoen/Mikrocontrolleren.

- Knap #2

– Denne knap sender et signal til Arduinoen/Mikrocontrolleren.

- Knap #3

– Denne knap sender et signal til Arduinoen/Mikrocontrolleren.

- Knap #4

– Denne knap sender et signal til Arduinoen/Mikrocontrolleren.

- Knap #5

– Denne knap sender et signal til Arduinoen/Mikrocontrolleren.

- BlueSmirf

– BlueSMiRF komponenten “Silver mate” er forbundet til Arduinoen. BlueSMiRF’en sender og modtager signaler fra Arduinoen. Arduinoen fungerer som strømforsyning til BlueSMiRF’en.

## 4 Hardware

### 4.1 Stepper motor

En stepper motor, også ofte kaldt en “stepper” er en type af elektrisk motor som kan bruges til mange forskellige ting. En af fordelene ved at bruge en stepper motor i stedet for en DC motor er, at bevægelsen med stepper motor kan gøres meget præcist i forhold til en DC motor. Dette kommer sig af navnet “stepper motor”, da motoren ikke har en “flydende” kontinuerlig bevægelse, men bevæger sig frem i trin.

Bevægelsen bestemmes af magnetiske poler som tændes og slukkes alt efter hvilken retning og mængde af trin der ønskes, en stepper kræver altså en eller anden form for driver, dette kan som eksempel forekomme i form af en H-bro. Trin styres af to forskudte magnetiserede tandhjul som stemmer overens med en af de to sæt magnetiske poler, disse sidder forskudt på en sådan måde at når den ene aktiveres, trækkes det nærmeste sæt tænder med modsat polaritet frem, herefter tændes den anden pol for at rykke det andet sæt tænder frem¹

I vores kredsløb har vi brugt stepmotorer til at kontrollere retningen på vores kanontårn, en som rotere tårnet om dens centrum, og en som styre vinklen på selve geværet.

### 4.2 DC motor

En DC motor er simpel en elektromagnetisk motor som fungerer på det samme princip som en stepmotor. Ved at kontrollere mængden og “retningen” af strømmen som løber igennem denne motor kan motoren kontrolleres til et vist punkt. I modsætning til en stepmotor er det begrænset hvor præcist en DC motor kan styres, dog har den en flydende bevægelse samt er den mere enkel i sin funktion og er derfor lettere at kontrollere.

I stærk kontrast til en stepmotor har en DC motor kun to mulige forbindelsespunkter. Retning er baseret på hvordan strømforsyningen er koblet til, og hastighed er baseret på den spænding som der bliver tilført. Ved kun at have to forbindelsespunkter, samt at magneterne altid er tændt på samme tid bliver motoren langt mere enkel at bruge i forhold til en stepmotor da der ikke opstår problemer med paritet mellem de forskellige magnet elementer.

### 4.3 H-bro

En H-bro bliver brugt til at ændre strømmens retning gennem et kredsløb. Ved at styre strømmen gennem fire porte kan man tænde og slukke for ønskede elementer

1Video og artikel om stepmotorer: https://youtu.be/0qwrnUeSpYQ og https://www.instructables.com/id/How-to-use-a-Stepper-Motor/

baseret på outputs fra en arduino. I dette projekt bruger vi H-broen til at tænde for de individuelle magneter på vores stepmotorer for at skabe, og styre, rotation. At bruge en H-bro skaber også en mængde problemer, foruden problemer med opsætning og software, falder den spænding som bliver sendt til motoren med omkring 2 volt ved brug af en standard arduino H-bro (L298N²
).
Dette kan resulterer i at motoren er knap så stærk, da dennes styrke afhænger af hvor meget strøm elektromagneterne får.

### 4.4 Knapper

I dette projekt er der blevet brugt flere knapper. Knapper kan bruges til at registrere et brugerinput. Knapper bliver ofte brugt når man skal bruge et simpelt input. F.eks. bruges knapper i dette projekt til at registrere, hvornår hardball pistolen skal skyde ud fra brugerens tryk.

Knapper fungerer ved at en mikrocontroller kan afmåle en spændingsforskel som knappen skaber. En ATMega328p kan afmåle disse spændingsforskelle gennem de digitale input / output.

### 4.5 Relæ

Et relæ er en kontakt, som kan videresende strøm, hvis det aktiveres. Det bliver aktiveret ved at strømmen skaber et elektromagnetisk felt, som er stærkt nok til at lukke kontakten inde i relæet.

Vi bruger relæet til at tænde og slukke for skydemekanismen i airsoft-geværet ved hjælp af strømmen fra mikrocontrolleren, som tænder for relæet, der derefter lader strømmen fra geværets batteripakke gå igennem, hvilket resulterer i affyring.

### 4.6 BlueSMiRF

I dette projekt bruger vi flere bluetooth kommunikationselementer af typen “BlueSMiRF Silver”. Disse er simple, kommandobaserede kommunikationsmodemmer, som kan bruges gennem arduino. Dette gør det muligt at bruge dem i kombination med mange af de andre komponenter i vores produkt.

Bluetooth-kommunikation fungerer ved svage, sekvensbaserede radiosignaler mellem forskellige enheder. Dette kommer sig af, at det originalt var tiltænkt som en trådløs løsning til overførsel af data fra enheder som mobiltelefoner, som ikke har adgang til en høj spænding. Enheder inddeles i de to kategorier “slave” og “master”. Masteren er

2Data om standard Arduino H-bro, Underemnet: L298N https://howtomechatronics.com/tutorials/arduino/arduino-dc-motor-control-tutorial-l298n-pwm-h-bridge/ (https://howtomechatronics.com/tutorials/arduino/arduino-dc-motor-control-tutorial-l298n-pwm-h-bridge/)

den enhed som starter kommunikationen mellem de forbundne enheder. Den bestemmer også, hvornår slaverne må sende deres signal for at holde selve kommunikationen synkron mellem slaverne og masteren³

I vores projekt har vi en master forbundet til vores controller og en slave forbundet til selve tårnet, her sender masteren så de input den får gennem seriel kommunikation til slaven som er forbundet på selve tårnet. Slaven modtager et enkelt tegn baseret på et knaptryk, som den så udføre en handling ud fra, dette kunne for eksempel være at fortælle stepmotoren at den skal køre en enkelt omgang.

### 4.7 Accelerometer

Et accelerometer er en elektronisk komponent som kan måle sin egen tyngdeacceleration. Mange accelerometerer kan aflæse sin tyngdeacceleration på tre akser (x, y og z).

Man kan bruge et accelerometer til at bestemme et legemes rotation i rummet.

I dette projekt har vi brugt et accelerometer til at bestemme hældningen på vores gevær, og den har haft til opgave at stoppe geværet fra at hæve eller sænke sig for meget ved kombineret brug af accelerometer og interrupt i kode. Ved at vurdere sin placering har accelerometeret kunne bestemme om geværet er oversteget nogle forudbestemte maksimums- og minimumsværdier for geværet hældning, og har så, baseret på disse værdier, stoppet geværet i at hæve eller sænke sig mere end hvad er tilladt.

### 4.8 Spændingsregulator

En spændingsregulator virker som en zenerdiode, der kun tillader strøm op til en bestemt spænding at løbe igennem. Zenerdioder adskiller sig fra normale dioder ved, at de ikke prøver at spærre for alt strøm, men i stedet kun spærrer for strøm, som overstiger spændingsgrænsen.

Vi har i projektet brugt spændingsregulatoren LM7805, da denne korrekt nedskalerer vores strømkilde (9V) til de 5V en ATMega328p må få. Mere om kredsløbet, som komponenten indgår i kan findes under afsnittet om mikrocontrollerens el-diagram.

### 4.9 Mikrocontroller (ATMega328p)

ATMega’en er en programmerbar mikrocontroller, der er standardchippen i en Arduino UNO, hvilket betyder at den kan programmeres igennem Arduino IDE’en. Mikrocon-

3
Information om Bluetooth: https://www.elprocus.com/how-does-bluetooth-work/

trolleren har 28 pins, hvor af 13 er digitale pins (PD# og PB#) og 6 kan bruge PWM (pulse width modulation). Derudover har mikrocontrolleren 8 analoge pins (PC#), hvor PC6 også er controllerens reset-pin, samt 2 VCC, 2 GND og en reference spænding (AREF).

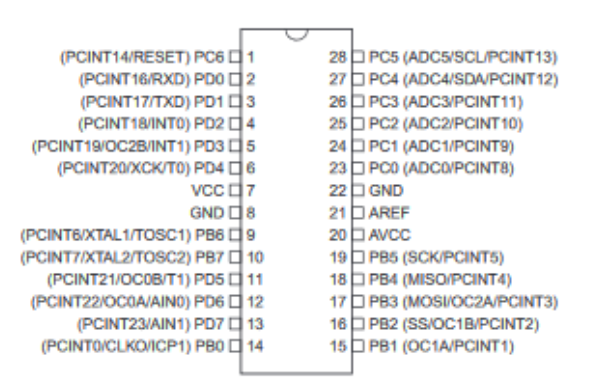
[picture p24: figure]

Fig. 9: Billede af ATMega328p’s pin layout.

Vi har i modsætning til tidligere projekter brugt en ATMega328p uden, at den sidder fast i en Arduino. Hvis denne sættes korrekt op, kan den dog udføre de samme opgaver, selvom dens programmering kompliceres ved, at den enten skal fastspændes i en Arduino hver gang, eller have en forbindelse mellem Arduino’ens TX og RX og ATMega’ens RX og TX (PD0 og PD1). Hvordan ATMega’en sættes op udenfor en Arduino kan ses under det næstkommende el-diagram afsnit.

### 4.10 Krystaloscillator

Vi bruger en 16 MHz krystaloscillator til at holde styr på ATMega’ens tidstagning. Krystallen virker ligesom en oscillator, da den bringes i stabile svingninger af strømmen fra mikrocontrolleren. Krystallens store stabilitet gør den i stand til at holde tiden ekstremt præcist, hvilket gør den ideel, hvis dele af ens kode kræver tidsstyring, som f.eks. præcise delays.

Mere om vores brug af krystaloscillatoren kan findes i afsnittet om mikrocontrollerprintet.

### 4.11 El-diagrammer

### 4.11.1 Mikrocontrollerprint

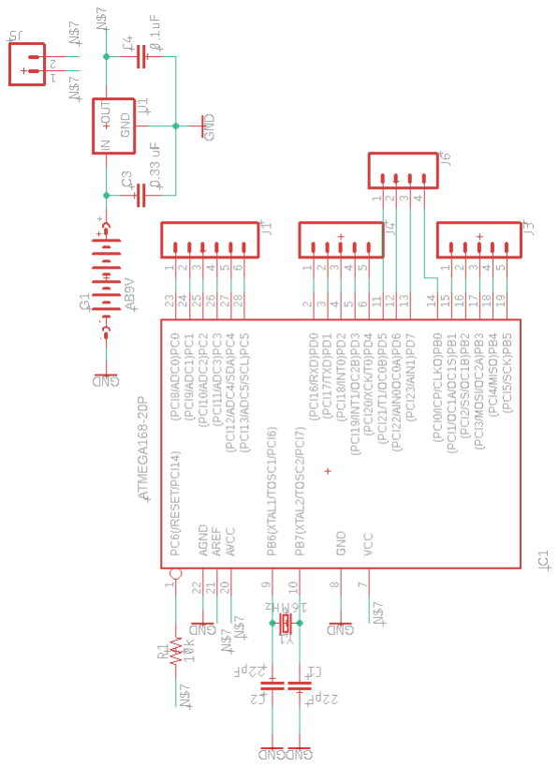
[picture p25: figure]

Fig. 10: El-diagram over mikrocontrollerprint.

Selve mikrocontrollerprintet består af 2 forbundne kredsløb. Det første er selve AT-MEGA’en, som er udstyret med en krystaloscillator (Y1 på figur 10), som er yderligere forklaret under hardware-afsnittet. Der er forbundet 2 kapacitorer mellem krystaloscillatoren og GND for at forbedre strømmens stabilitet. Krystaloscillatorens størrelse (16 MHz), samt kapacitorernes størrelse (22 pF) er baseret på ATMega’ens datablad, hvor disse er foreslået⁴

Derudover er der lavet huller til alle ATMega’ens resterende pins, så de kan bruges frit, ligesom på en Arduino. Ligesom det kan ses på el-diagrammet er ATMega’ens 2 GND pins forbundet til pladens GND og de to VCC pins, samt AREF er forbundet til den regulerede 5 volts kilde. Arduino’ens reset-pin er forbundet til 5 volts kilden igennem en 10 kΩ resistens, så spændingen forhindrer ATMEGA’en i at genstarte af sig selv.

Det andet, mindre kredsløb på mikrocontrollerprintet er spædningsregulatoren, som kan ses øverst til højre på figur 10. Denne er tilstede, da mikrocontrolleren ikke må få mere end 5V. De to kapacitorer, som er tilsluttet selve spændingsregulatoren sørger for bedre stabilitet og er tilføjet, da dette var opfordret i komponentens datablad, hvis man vil have et konstant 5V output⁵
4ATMega | datablad, | afsnit | 9.4: | http://ww1.microchip.com/downloads/en/DeviceDoc/
ATmega48A-PA-88A-PA-168A-PA-328-P-DS-DS40002061A.pdf (http://ww1.microchip.com/downloads/en/DeviceDoc/ATmega48A-PA-88A-PA-168A-PA-328-P-DS-DS40002061A.pdf)
5M7805 datablad, side 7: https://www.sparkfun.com/datasheets/Components/LM7805.pdf

### 4.12 PCB-layout

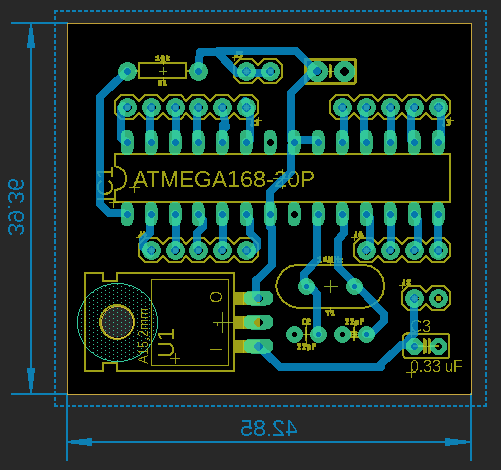
[picture p26: figure]

Fig. 11: PCB-layout med angivede mål. Uden kobber på pladen.

Layout’et er lavet i Eagle ud fra el-diagrammet på figur 11. Alle komponenterne er placeret, så de fylder så lidt som muligt, men samtidig er mulige at lodde præcist i hånden. Som det kan ses på figur 11, har vores mikrocontrollerprint dimensionerne: 42,85 x 39,36 mm.

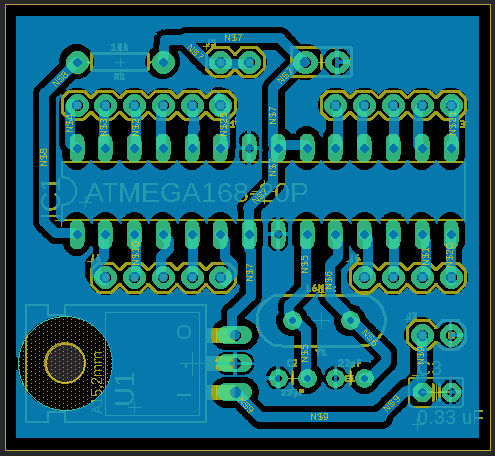
[picture p27: figure]

Fig. 12: PCB med kobber (GND) på pladen.

Som illustreret på figur 12, er der én samlet GND på pladen, som alt er forbundet til. Dette sparer meget plads, hvis sammenlignet med en løsning, hvor f.eks. en Arduino skulle have sin egen separate GND. Hvis man tænker på at hele mikrocontrollerprintet, egentlig bare er en simpel Arduino, giver det også mening at den skal være så lille som muligt, da dette er den “hjemmelavede” Arduinos største fordel, hvis sammenlignet med en standard Arduino UNO. En Arduino UNO vil f.eks. ikke kunne passe ind i en kompakt controller, mens dette mikrocontrollerprint ville kunne pakkes meget kompakt med dets minimale dimensioner.

## 5 Software

I dette afsnit gennemgåes de forskellig dele af softwaren ved brug af flowcharts og psedokode.

### 5.1 Generelt

I dette projekt har vi skulle skrive en form for “OS” (Operating System) til vores kanontårn. Denne OS skal selvfølgelig stemme overens med opgavens krav. Den skal altså kunne bruges på et arduino chipset, samt være i stand til at afbryde handlinger baseret på input fra en controller-enhed.

### 5.2 IDE og sprog

Som sagt er der i projektet skrevet et program til et Arduino chipset. Selve programmet skal altså skrives i et sprog som Arduinoen kan forstå. I dette tilfælde er der skrevet i det Arduino dedikerede sprog, også kaldet Wire, som er en forgrening af de meget udbredte sprog “C” og “C++”⁶
. Der er i projektet også brugt Arduinos egen basis IDE (Integrated Development Environment) da selve funktionerne og fejlfinding i dette projekt ikke har været problematisk nok til at kunne understøtte at bruge tid på at finde en udvidelse eller helt nyt udviklingsmiljø.

### 5.3 Indsamling af viden om Arduino software

I projektet har vi skulle bruge mange nye komponenter for at kunne opfylde de stillede krav. Dette har resulteret i, at det har været nødvendigt at søge ny information. Basisprincipper vedrørende de nye komponenter er primært fundet fra siden “Sparkfun”⁷ ,
som har mange gode eksempler på både brug af komponenter og de mange forskellige måde som disse kan kobles til, og kommunikeres med gennem Arduino⁸
. Udover denne
hjemmeside har spørgsmålssegmentet på Arduinos egen hjemmeside ofte givet gode råd og har kunnet besvare spørgsmål med deres store forum.

6https://www.arduino.cc/en/Main/FAQ7https://learn.sparkfun.com/tutorials/using-the-BlueSMiRF/all 8Problemløsning med knapper:https://www.arduino.cc/en/Tutorial/Button

### 5.4 Program flow

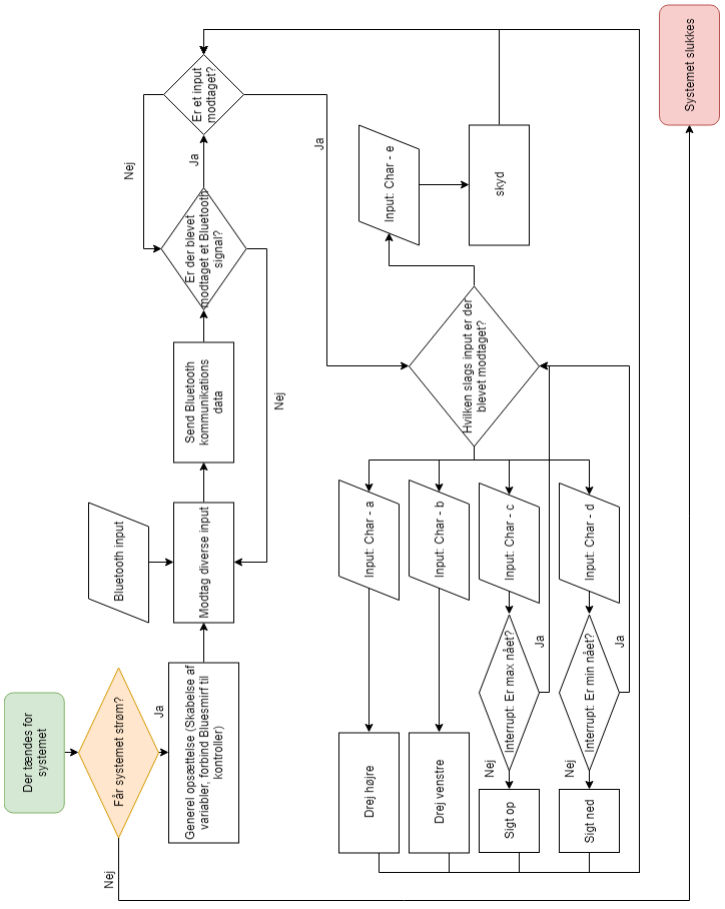
[picture p28: figure]

Fig. 13: Flowchart over softwarens logik.

### 5.5 Psedokode

### 5.5.1 Controller

Oenskede biblioteker inkluderers, her bliver biblioteket “SoftwareSerial” inkluderet da dette skal bruges til seriel kommunikation mellem de to BlueSMiRF silver mates.

Foerst opsaettes Pins og globale vaerdier:
//Nedenstaaende er pins som bruges til knapper
KnapVenstre = 4
KnapHojre = 5
KnapOp = 6
KnapNed = 7
KnapSkyd = 8
//Variabler til registreing af knaptryk KnapStateVenstre = 0
KnapStateHojre = 0
KnapStateOp = 0
KnapStateNed = 0
KnapStateSkyd = 0
//Bluetooth pins til kommunikation oprettes BluetoothTx = 2
BluetoothRx = 3

Herefter opsaettes “Void setup” hvor pins defineres til inten OUTPUT eller INPUT, og bluetooth kommonikations paabegyndes.
Knap pins saettes til input
Serial port startes ved standard baudrate paa 9600
Bluetooth opstartes ved standard baudrate paa 115200
Kommandosekvens paabegyndes.
Naar kommandosekvensen har koert saettes baudraten ned fra 115200 til 9600 for ikke
At skabe problemer med arduino kommunikation.
Print “Ended Setup”

Der oprettes en boolsk vaerdi til at vurdere om kommandosekvens til opretelse af denne bluetoothenhed som master har koert.

Void loop:
Der oprettes fem led i et elif statement til at sende fem kommando karaktere: Hvis knaptryk(a,b,c,d eller e):
Send a,b,c,d eller e gennem bluetooth (korresponderende bogstav til knaptryk) Vent 250 millisekunder.
Hvis bluetooth er tilgaengelig:

printes alle karaktere som er blevet sendt eller modtaget paa denne enheds serial monitor.
Ellers:
printes der ikke noget.

### 5.5.2 Turret

Oenskede biblioteker inkluderers, her bliver biblioteket “SoftwareSerial” inkluderet da dette skal bruges til seriel kommunikation mellem de to BlueSMiRF silver mates.

Først opsaettes Pins og globale vaerdier:
//Nedenstaaende er pins som bruges til at styre diverse dele af systemet:
Hojre = 8 // 8 og 9 er til rotationsmotor
venstre = 9
Op = 10 // 10 og 11 er til at panorere op eller ned
Ned = 11
Skyd = 12 // pin 12 er til at skyde med
LedPin = 13 // Til interrupt

Volatile int state = LOW // Kontrol af led i interrupt, dette state er som standard LOW

//Bluetooth pins til kommunikation oprettes
BluetoothTx = 3
BluetoothRx = 4

Herefter opsaettes “Void setup” hvor pins defineres til inten OUTPUT eller INPUT, og bluetooth kommonikations påbegyndes.
Foerst startes seriel kommunikation ved en baudrate på 115200 som standard. Herefter initieres kommandosekvens.
En kort pause for at sikre at mate’n sender cmd.
Pins til kontrol saettes alle til OUTPUT.
Serial kommunikation startes ved standard baudrate på 9600 da 115200 kan vaere for hurtigt til stabil kommunikation.
Pins til motor og skud kontrol oprettes som OUTPUT.
Interrupt oprettes til funktionen “blink” ud fra parameteren “state” og en aendring i
state.
Led Pin saettes til OUTPUT
InterruptstandardpinINT 0saettestil\INP UTP ULLUP”somhiverinterruptsegmentetfremi\stack”.

Interrupt funktionen “Blink” oprettes:
State = !state // her sker en aendring hvis et interrupt forekommer.

Void loop:
Først sikres det at alle OUTPUT pins er LOW
Hvis bluetooth er tilgaengelig:
Opret switch statement med en case for hvert kommando tegn fra controleren, Altså a, b, c, d og e, som henholdsvis kontrolere en bestemt handling.

### 5.6 Programbeskrivelse/gennemgang

Selve Kanontårnets og controllerens OS er lavet i arduino til brug på både arduino UNO chipsæt og gruppens egen mikrocontroller. programmet indsamler data fra en sensor og flere forskellige knapper og bruger disse data til at bestemme tårnets handling.Hvis kanontårnet modtager en værdi baseret på et knaptryk fra controlleren vil tårnet udføre en af disse handlinger: Drej til højre, drej til venstre, panorer op, panorer ned og skyd. Hvis kanontårnet kommer til en max eller min værdi for geværets “hældning” registrere accelerometeret dette og bruger interrupt til at stoppe geværet fra at hæve eller sænke sig. Hvis ikke kanontårnet får noget input, eller ikke får noget bluetooth signal vil tårnet forholde sig í ro.

## 6 Ikke elektroniske dele

I dette afsnit gennemgås produktionen af de ikke-elektriske dele af produktet og mikrocontrollerprintet.

### 6.1 Production af kanontårn

Hele den fjernstyret kanon er holdt sammen af et kanontårn. Dette “skelet” er lavet af MDF (Medium Density Fiberboards) plader. Der er i alt fire forskellige plader. To af pladerne bruges som bunde, som skaber rotation om z-aksen. De sidste to plader fungerer som arme, som griber rundt om våbnet. Disse arme tillader rotation om x/y-aksen.

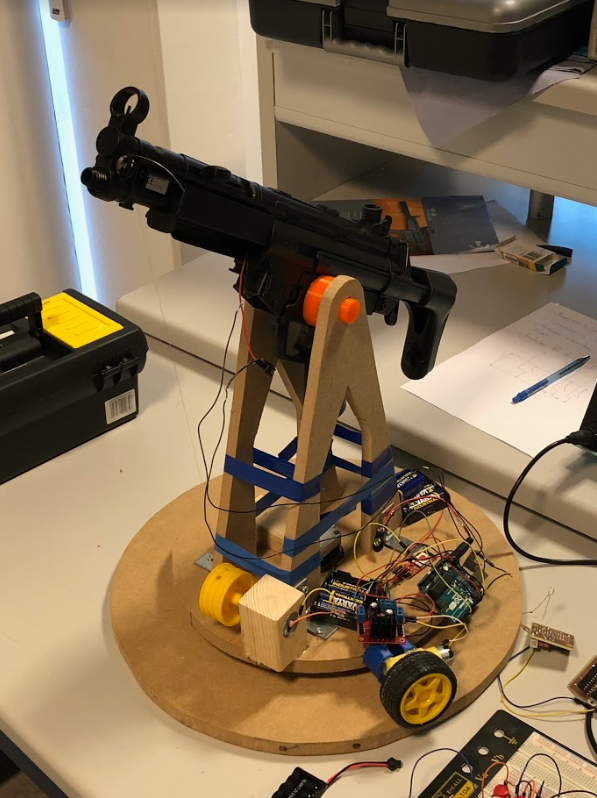
[picture p29: figure]

Fig. 14: Det faerdiglavet produkt hvor skelettet kan ses.

De fire plader er designet på sådanne måde, at de skal veje så lidt som muligt. De er blevet designet på sådanne måde, da motoren som sørger for rotation om z-aksen er mere effektiv, jo mindre vægt den skal flytte. Derudover er skelettet designet rundt om hardball-våbnet BT5⁹
, som monterers på skelettet.

9https://www.legbilligt.dk/shop/14-el-gevaer---billige-softguns/238-bt---bt5-a5-kompletsaet/ (https://www.legbilligt.dk/shop/14-el-gevaer---billige-softguns/238-bt---bt5-a5-kompletsaet/)

### 6.2 Production af 3D print

Ud over de fire MDF plader er der også blevet produceret 3D-printet komponenter til kanontårnet. Alle de 3D-printede komponenter er lavet i Autodesk Fusion 360.

Alle de 3D-printede komponenter er designet til at hjælpe motoren med at roterer.

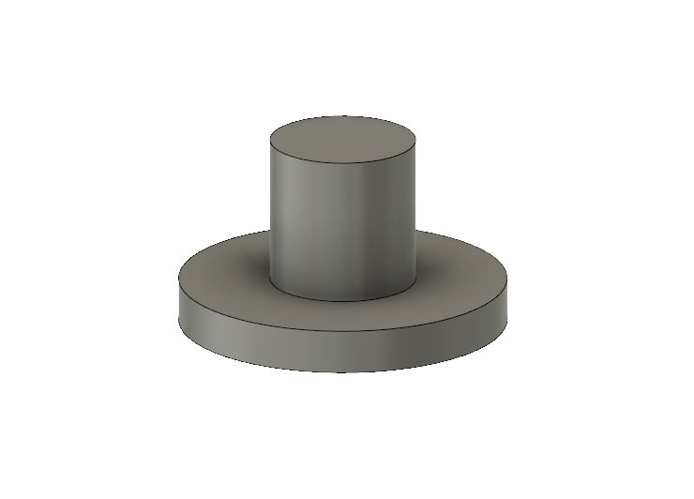
[picture p30: figure]

Fig. 15: 3D-print som hjaelper med x/y-rotation.

Dette komponent kan findes på begge sider af den monteret hardball pistol. Dette komponent hjælper med rotationen om x/y-aksen.

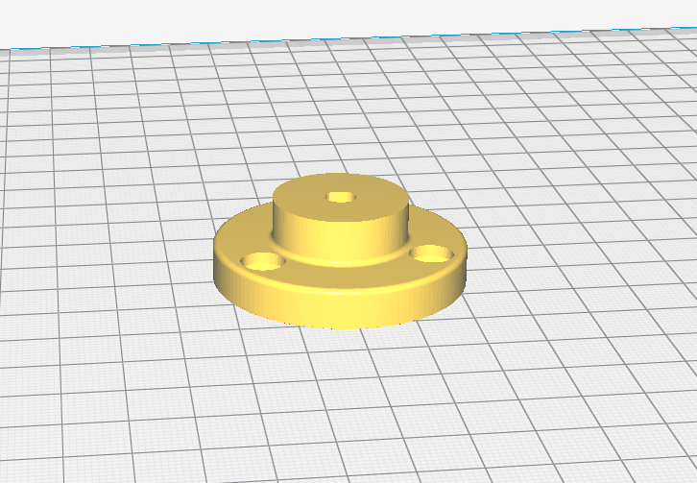
[picture p31: figure]

Fig. 16: 3D-print som hjaelper med z-rotation.

Dette komponent kan findes mellem de to MDF bundplader og hjælper med rotation om z-aksen.

### 6.3 Production af mikrocontrollerprint


Fig. 17: Det gennemsigtige papir, som blev brugt til maalrettet belysning af kobberpladen.

Printet er anmærket ved at belyse en kobberplade dækket med lysfølsomt materiale gennem et gennemsigtigt papir, hvor kredsløbet er anmærket (se figur 18).

Printet er herefter blevet nedsænket i en svag natriumhydroxidopløsning, der kun fjerner den lysfølsomme belægning fra det belyste område. Dette gør, at når printet herefter nedsænkes i et syrebad, vil kun det kobber, hvorfra det ekstra lysfølsomme lag er opløst, blive ætset væk. Når dette er sket placeres printet i en stærkere natriumhydroxidopløsning, så resten af det lysfølsomme lag forsvinder.

## 7 Aftestning

### 7.1 Test med præfabrikeret H-bro (L289N)

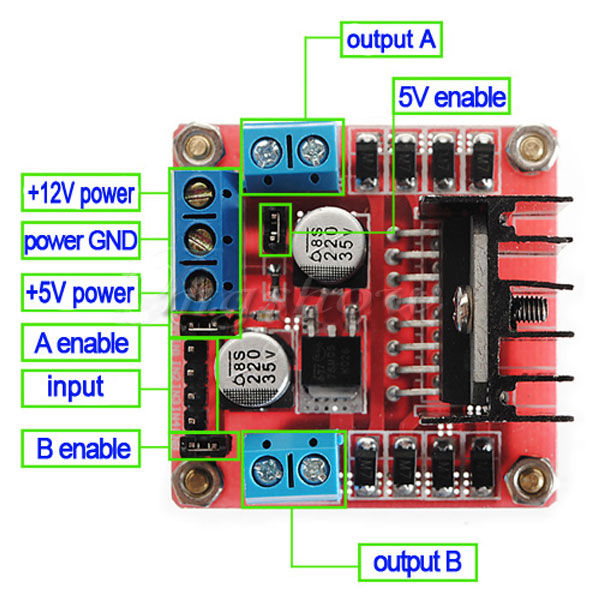
[picture p32: figure]

Fig. 18: En forudproduceret H-bro.

Til aftestning har gruppen gjort brug af en L289N-enhed. Dette er en færdig H-bro som bruges til at controllere retning og omdrejninger på en stepmotor/DC motor. Denne enhed har op til 6 input pins samt 1-2 pins til strømforsyning. Den ene af disse pins kan laves om til et output for en lav strømforsyning, for eksempel til en arduino, hvis der er forbundet en strømforsyning til den anden port på +12V. Den sidste pin skal forbindes til ground.

### 7.2 Test af knapper

Som en del af vores produkt har vi produceret en trådløs controller til at styre vores tårn med. denne controller fungere ved input gennem fem knapper, en til hver kommando. I vores forløb har vi prøvet flere forskellige opsætning af knapper, med hver deres modstand, en enkelt, og brug af forskellige ledninger. Det er blevet bestemt ud fra forsøg at et sådant knapsystem fungere bedst hvis alle knapper har deres egen modstand inden de går til jord, samt at mere ukonventionel opsætning og placering generelt skaber flere problemer end de løser. Ved brug af samme placering som på moderne spillemaskinecontroller opstod der signalforstyrrelser som ikke var til at fjerne, og ved en enkelt stor modstand blev signalerne fra knapperne sjældent stoppet når de var blevet trykket ned.

I sidste ende har vi valgt at lave en række med fem knapper med hver deres modstand og en kombineret forbindelse til jord.

### 7.3 Aftestning af mikrocontroller og mikrocontrollerprint

Inden arbejdet med selve mikrocontrollerprintet begyndtes, testede vi kredsløbet på et fjumrebræt for at sikre, at det virkede som tiltænkt inden produktionen af printet startedes, da en fejl i printets design tager meget længere tid at fikse, hvis den opdages for sent.

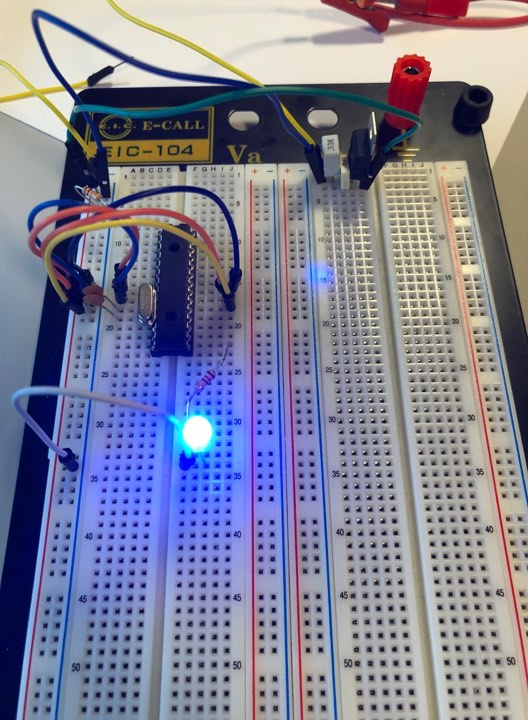
[picture p33: figure]

Fig. 19: Foerste test af mikrocontrollerprintet på et fjumrebraet. Oeverst til hoejre kan spaendingsregulatoren ses, mens ATMega’en og de tilhoerende forbindelser er til venstre.

Efter at testen, som gik ud på at få en lysdiode til at stige og falde i lysstyrke, virkede på fjumrebrættet, kunne selve produktionen af mikrocontrollerprintet begynde. Da printet var blevet færdigproduceret testede vi alle forbindelser på det, for at opdage eventuelle produktionsfejl.


Fig. 20: Kobberforbindelserne på det nylavede mikrocontrollerprint.

Det første print vi lavede havde en fejl, da det var blevet spejlvendt under produktionen, hvilket gjorde at alle de “ikke-spejlbare” komponenter (ATMega328p og LM7805) skulle loddes fast på den modsatte side af printet, end hvor man normalt gør det. Der skulle altså loddes under selve komponenten istedet for på den anden side af printet. Det kom dog til at virke, selvom det var betydeligt mere vanskeligt loddearbejde end normalt.

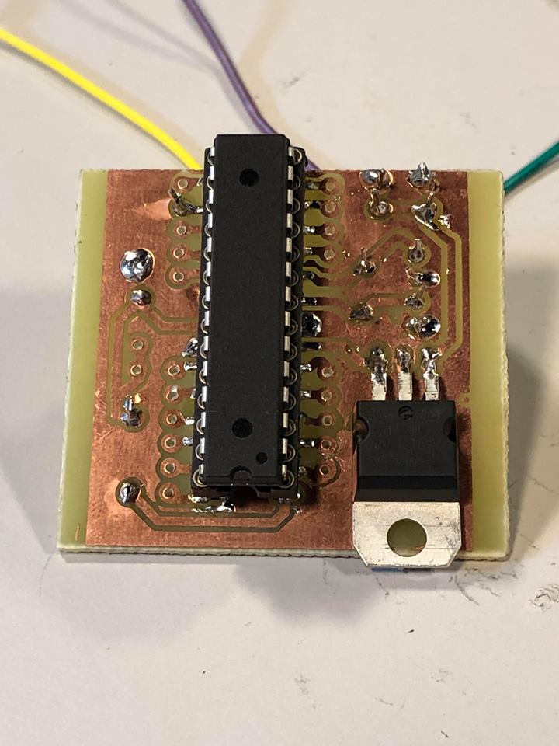
[picture p34: figure]

Fig. 21: Det færdiglavede og fuldt funktionelle spejlvendte print.

Vi testede printets funktionalitet ved brug af den samme test, som før printarbejdet blev påbegyndt, da denne derfor var bevidst til at skulle virke. Vi lavede også et andet print, da vi ikke var sikre på om den spejlvendte kunne loddes korrekt, men denne havde flere produktionsfejl, da den manglede de anmærkede kobberbaner flere steder. Dette førte til, at den blev næsten umulig at lodde korrekt og skulle kasseres.

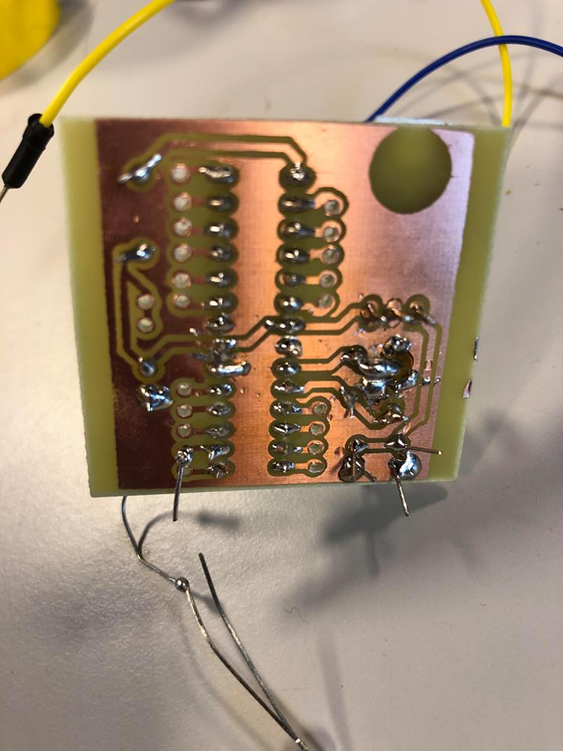
[picture p35: figure]

Fig. 22: Loddefejlen nederst til hoejre på fejlprintet skyldes de manglende/beskadigede kobberbaner.

### 7.4 Problemer under udviklingen af produktet

### 7.4.1 Problem #1 - Stepper motor vs. DC motor

I den største del af projektet har vi i gruppen forsøgt at gøre brug af to stærke stepper motorer til at hæve og sænke geværet samt dreje selve platformen. Vi har dog haft store problemer med bare at få disse motorer til at lave simple rotationer. Det første problem vi stødte på var ikke at få selve motoren til at køre, det var at dem vi havde fundet var for svage og havde en for lav trækkraft. Disse blev så skiftet ud med to større motorer, som hver har en trækkraft på cirka 10 kg. Disse havde dog også et meget stort problem, de virkede kun halvdelen af tiden, den anden halvdel vibrerede de bare. Problemet opstod formentlig i enten koden eller selve kredsløbet, men begge disse er blevet ændret på alle tænkelige måder for at løse dette problem. I sidste ende har vi skiftet begge stepper motorer ud med DC motor, disse er både lettere at bruge, samt har de ingen af de samme problemer som stepper motorne havde. Der er dog et argument for at selve tårnets bevægelse ikke er lige så præcis, dog var selve ideen at den skulle dreje efter hvor længe man holder en bestemt knap inde, så selve den endelige bevægelse bliver ikke påvirket af dette skift af motoren.

### 7.4.2 Problem #2 - Flydende kommunikation

I den sidste del af projektet har vi haft problemer med flydende bevægelser ud fra vores givne kommandoer, i et normalt program uden trådløs kommunikation ville man kunne opnå en “flydende overgang” fra kommando til handling ved at definere det ud fra et HIGH/LOW state, dette er dog ikke tilfældet her. Da man er nødt til at sende information som pakker er der ikke mulighed for at sende et kontinuerligt signal som kan ændre sig på samme måde som et HIGH/LOW state. For at skabe en flydende overgang skal den “pause” altså det delay, som er mellem hver kommando og udførelsen af en handling passe sammen, hvis der går længere tid mellem handlinger end mellem kommandoer ville dette resultere i at man ville kunne “indhente” den del af hardware som udføre handlingerne og endda overhale den, så den udføre handlinger, selvom man ikke trykker noget på det tidspunkt. Hvis man derimod har kortere mellem handlinger end mellem kommandoer ville det se ud som om at der er et “input lag” hvilket der i princippet også er. De to skal altså stemmer overens, man stadigt ikke ske så hurtigt at programmet og de mere mekaniske dele af hardware ikke kan følge med.

I disse to stykker kode ses de to tider som skal stemmer overens:

1 // Tu r re t . i n o

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

13

1 // C o n t r o l l e r . i n o

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

5 | s e r i a l . p r i n t l n ( ”a” ) ;
6 | d el a y ( 2 5 0 ) ;
7 | }

I en længere periode var begge et helt sekund, dette resulterede i ringe kontrol og en fornemmelse af “lag” hvis man sænker tiden for handlingen uden at sænke for kommandoen vil der forekomme bevægelser i hak. 250 ms til hver lader til at være et sweet spot hvor der er en god følelse af kontrol, men også et punkt hvor motoren og H-broen kan nå at reagere på input fra Arduino.

## 8 Konklusion

Produktet opfylder alle de formelle krav, samt alle vores basiskrav til funktionalitet (fjernstyring, bevægelighed og kontrolleret affyring). Der er dog flere funktioner, som vi havde tiltænkt produktet, der desværre er blevet udfaset pga. andre tidskrævende problemer.

Selvom forbedringer ligesom mere avanceret fjernstyring med f.eks. en skærm, der viser hvor projektilet vil ramme baseret på vores videnskabelige dokumentation, og en bedre designet controller ville have gjort produktet mere færdigproduceret, har vi dog fået lavet et produkt, der virker og som potentielt ville kunne problemfrit opgraderes med disse funktionaliteter, hvis mere tid var til rådighed.

## 9 Litteraturliste

Teknisk Matematik af Preben Madsen, 4. Udgave.

Orbit B af Per Holck, Jens Kraaer og Birgitte Merci Lund.

http://www.matematikfysik.dk/fys/noter_tillaeg/tillaeg_det_skraa_kast_uden_luftmodstand.pdf (http://www.matematikfysik.dk/fys/noter_tillaeg/tillaeg_det_skraa_kast_uden_luftmodstand.pdf) af http://www.matematikfysik.dk. Senest læst den 19/12/2018.

http://www.matematiksider.dk/projekter/skraakast.pdf af http://www.matematiksider. dk. (http://www.matematiksider.dk) Senest læst den 19/12/2018

## 10 Bilag

Fysikrapport af Nikolai Aaen Bonderup, Sebastian Lassen og Lucas Mark Rasmussen.

Elektronik affald af Nikolai Aaen Bonderup, Sebastian Lassen og Lucas Mark Rasmussen.

Kode af Nikolai Aaen Bonderup, Sebastian Lassen og Lucas Mark Rasmussen.

Gruppekontrakt af Nikolai Aaen Bonderup, Sebastian Lassen og Lucas Mark Rasmussen.

Logbøger af Nikolai Aaen Bonderup, Sebastian Lassen og Lucas Mark Rasmussen.

## Kode

I dette dokument kan alt kode som findes i kanontårnet og i kontrollerne.

### Turret.ino

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

17
18 | i n t blue too thTx = 2 ; | // TX−O pin t i l bl u e t o o t h mate , Arduino D2
19 | i n t blue too thRx = 3 ; | // RX−I pin t i l bl u e t o o t h mate , Arduino D3

20
21 S o f t w a r e S e r i a l bl u e t o o t h ( bluetoothTx , blue too thRx ) ;

22

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

43
44 | S e r i a l . p r i n t ( ”Ended Setup” ) ;
45 | }

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

49
50 | v oid l o o p ( ) {
51 | i f ( c o n t r o l ) {
52 | bl u e t o o t h . p ri n t ( ”$$$ ” ) ; d el a y ( 1 0 0 0 ) ;
53 | bl u e t o o t h . p r i n t l n ( ”SM, 1 ” ) ; d el a y ( 1 0 0 0 ) ;
54 | bl u e t o o t h . p r i n t l n ( ”C, 0 0 0 6 6 6 8 6 7 4 5 c ” ) ; d el a y ( 1 5 0 0 0 ) ;
55 | bl u e t o o t h . p r i n t l n ( ”x” ) ; d el a y ( 1 5 0 0 0 ) ;

56
57 | f o r ( i n t x = 0 ; x < 1 0 0 0; ++x ) { } ; d el a y ( 1 0 0 ) ;

58
59 | bl u e t o o t h . p r i n t l n ( ”−−−” ) ; d el a y ( 1 0 0 ) ;

60
61 | c o n t r o l = ! c o n t r o l ;

62
63 | // S e r i a l . p r i n t ( ”Ends ” ) ;
64 | }
65 | // re ad the s t a t e o f the pushbutton v al u e :
66 | b u t t o n S t a t e L e f t = di gi t al R e a d ( b u t t o nPi nL e f t ) ;
67 | b u t t o n S t a t eRi g h t = di gi t al R e a d ( bu t tonPinRigh t ) ;
68 | buttonStateUp = di gi t al R e a d ( buttonPinUp ) ;
69 | buttonStateDown = di gi t al R e a d ( buttonPinDown ) ;
70 | bu t t on S t a te Sh o o t = di gi t al R e a d ( buttonPinShoot ) ;

71
72 | i f ( b u t t o n S t a t e L e f t == HIGH) {
73 | bl u e t o o t h . p ri n t ( ( ch a r ) ’ a ’ ) ;
74 | S e r i a l . p r i n t l n ( ’ a ’ ) ;
75 | d el a y ( 1 0 0 0 ) ;
76 | }
77 | e l s e i f ( b u t t o n S t a t eRi g h t == HIGH) {
78 | bl u e t o o t h . p ri n t ( ( ch a r ) ’b ’ ) ;
79 | S e r i a l . p r i n t l n ( ’b ’ ) ;
80 | d el a y ( 1 0 0 0 ) ;
81 | }
82 | e l s e i f ( buttonStateUp == HIGH) {
83 | bl u e t o o t h . p ri n t ( ( ch a r ) ’ c ’ ) ;
84 | S e r i a l . p r i n t l n ( ’ c ’ ) ;
85 | d el a y ( 1 0 0 0 ) ;
86 | }
87 | e l s e i f ( buttonStateDown == HIGH) {
88 | bl u e t o o t h . p ri n t ( ( ch a r ) ’d ’ ) ;
89 | S e r i a l . p r i n t l n ( ’d ’ ) ;
90 | d el a y ( 1 0 0 0 ) ;
91 | }
92 | e l s e i f ( b u t t o nS t a t eS h o o t == HIGH) {
93 | bl u e t o o t h . p ri n t ( ( ch a r ) ’ e ’ ) ;

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

105
106 | }
107 | e l s e {
108 | // Nothing happens
109 | }
110 | }

### Controller.ino

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

16
17 S o f t w a r e S e r i a l bl u e t o o t h ( bluetoothTx , blue too thRx ) ;

18
19 | v oid se tup ( )
20 | {
21 | S e r i a l . b e gi n ( 9 6 0 0 ) ; | // Begin the s e r i a l monitor a t 9600 bps

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

31 | bl u e t o o t h . b e gi n ( 9 6 0 0 ) ; | // S t a r t bl u e t o o t h s e r i a l a t 9600
32 | pinMode (R, OUTPUT) ;
33 | pinMode (L , OUTPUT) ;
34 | pinMode (U, OUTPUT) ;
35 | pinMode (D, OUTPUT) ;
36 | pinMode ( S , OUTPUT) ;
37 | }

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

83 | d el a y ( 1 ) ;
84 | break ;
85 | }

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
