Nikolaibonderup/P4---El-tek/Tekst/Problemanalyse.tex

%Dokument til Projektanalyse
\subsection{Projektanalyse}

I dette projekt skal vi kombinere Fysik A og el-tek til et SO forløb. I projektet er der flere faglige mål som skal opfyldes indenfor området el-tek og fysik. Selve opgaven lyder på at gøre brug af de elementer som er at finde under kravspecifikationer. I problemanalysen skal disse elementer altså gennemgås og der skal vurderes, hvilket et af dem bliver det største “problem” at arbejde med.\\

Det mest udfordrende bliver at få skabt kommunikation mellem selve kanonen og et kontrolelement. Der skal være en modtager og afsender, måske endda en af hver på både kontrolmodul og kanon-modulet alt efter hvor avanceret arbejdet med denne del af projektet skal være.\\

Et andet udfordrende problem bliver, hvordan selve lade- og affyringsmekanismen skal hænge sammen så den kan virke ved fjernstyring. Her skal flere forskellige typer motorer styres præcist gennem bluetooth.
