Nikolaibonderup/P4---El-tek/Billeder/ATMega.PNG

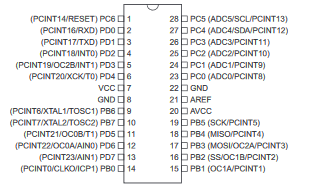
Billeder/ATMega.PNG
