Nikolaibonderup/P4---El-tek/Billeder/El-diagram.PNG

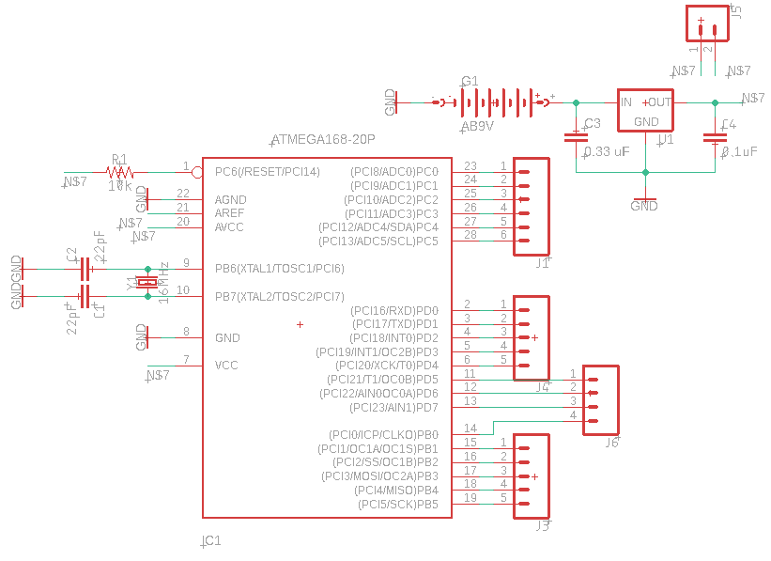
Billeder/El-diagram.PNG
