Nikolaibonderup/P4---El-tek/Billeder/Maeldata.png

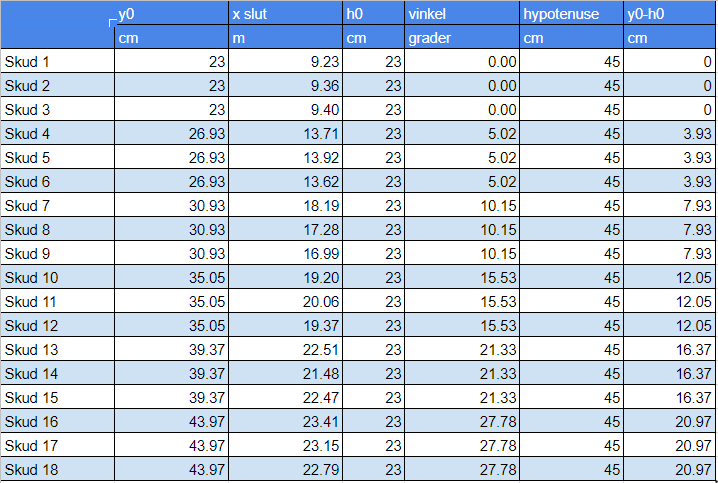
Billeder/Maeldata.png
