Nikolaibonderup/P4---El-tek/Billeder/PCB_uden_kobber.PNG

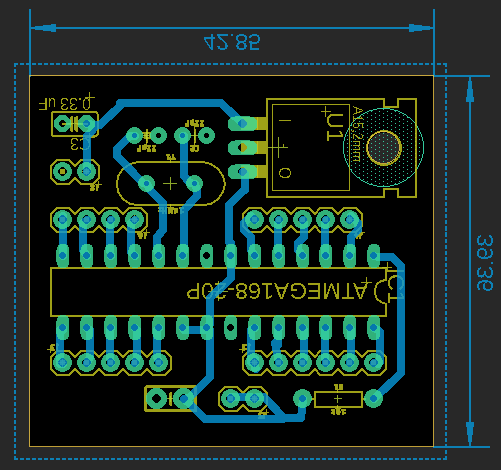
Billeder/PCB_uden_kobber.PNG
