Nikolaibonderup/P4---El-tek/Billeder/ProgramFlowchart.png

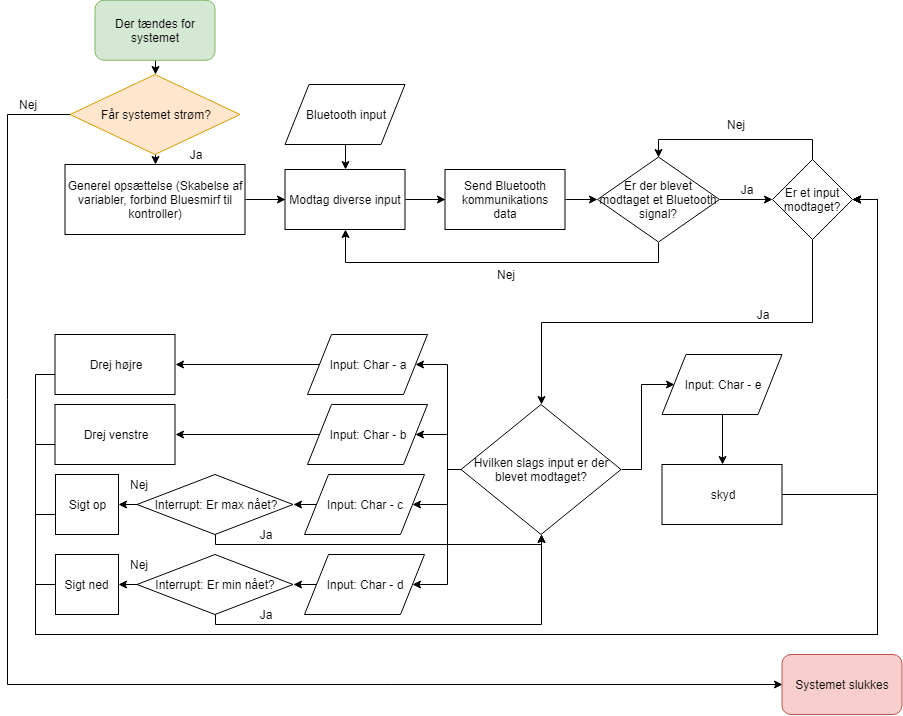
Billeder/ProgramFlowchart.png
