Nikolaibonderup/P4---El-tek/Billeder/skrakast.png

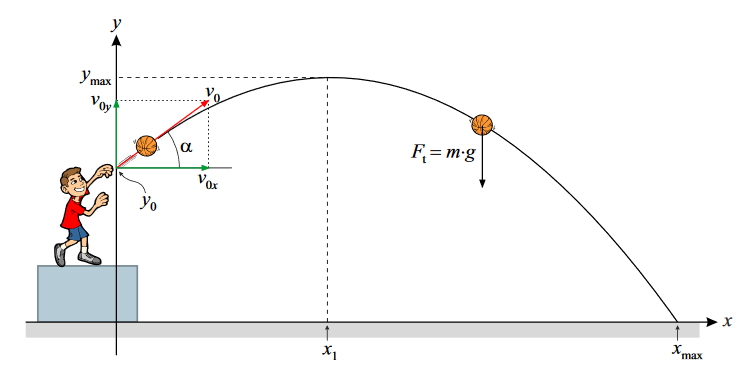
Billeder/skrakast.png
