Nikolaibonderup/P4---El-tek/Billeder/tidsplan_1.PNG

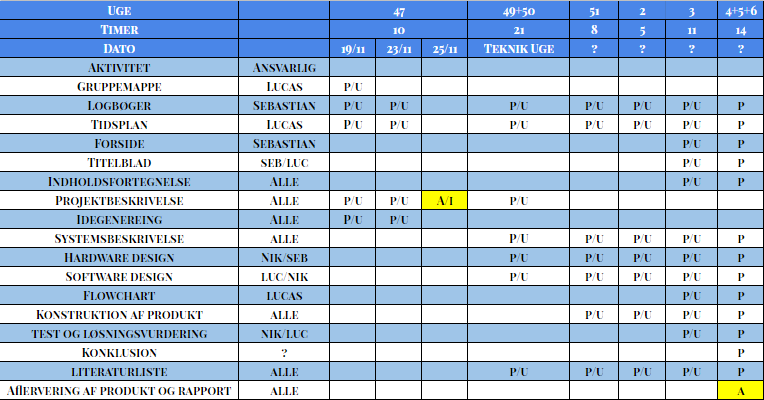
Billeder/tidsplan_1.PNG
