Nikolaibonderup/P4---El-tek/Billeder/Tidsplan_23_11_2018.PNG

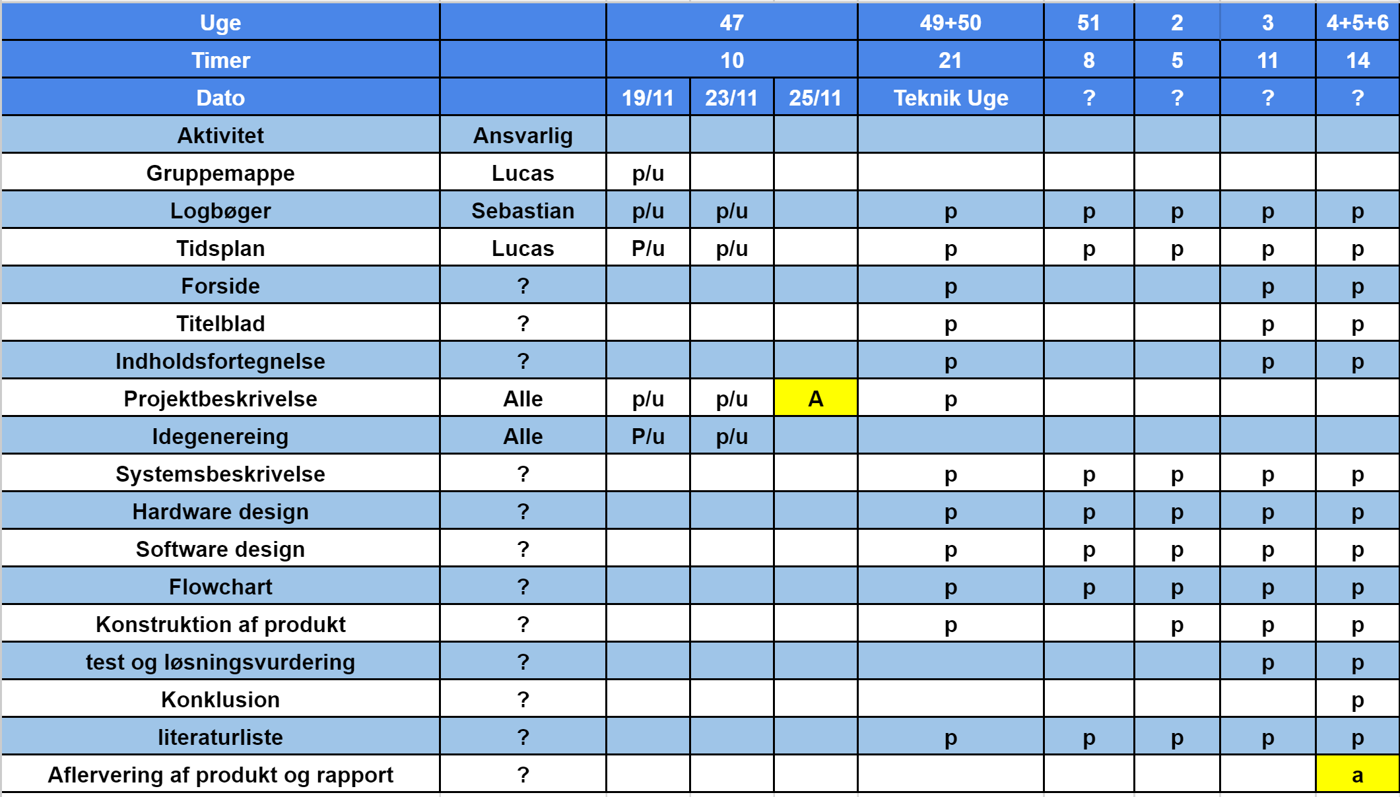
Billeder/Tidsplan_23_11_2018.PNG
