Nikolaibonderup/P4---El-tek/Tekst/PageSetup.tex

\usepackage[dvipsnames]{xcolor}
\usepackage{graphicx}
\usepackage[margin = 3 cm]{geometry}
\usepackage[english]{babel}
\usepackage[utf8x]{inputenc}
\usepackage{amsmath}
\usepackage[colorinlistoftodos]{todonotes}
\usepackage{listings}
\usepackage{float} %For image positioning
\usepackage{subcaption} %For even more image positioning
\usepackage[figurename=Fig.]{caption}
\usepackage{rotating}
\usepackage{hyperref}
\usepackage{xcolor}

\definecolor{mGreen}{rgb}{0,0.6,0}
\definecolor{mGray}{rgb}{0.5,0.5,0.5}
\definecolor{mPurple}{rgb}{0.58,0,0.82}
\definecolor{backgroundColour}{rgb}{0.95,0.95,0.92}

\lstdefinestyle{CStyle}{
    backgroundcolor=\color{backgroundColour},   
    commentstyle=\color{mGreen},
    keywordstyle=\color{magenta},
    numberstyle=\tiny\color{mGray},
    stringstyle=\color{mPurple},
    basicstyle=\footnotesize,
    breakatwhitespace=false,         
    breaklines=true,                 
    captionpos=b,                    
    keepspaces=true,                 
    numbers=left,                    
    numbersep=5pt,                  
    showspaces=false,                
    showstringspaces=false,
    showtabs=false,                  
    tabsize=2,
    language=C
}
