Nikolaibonderup/P4---El-tek/El/PCB til print.pdf

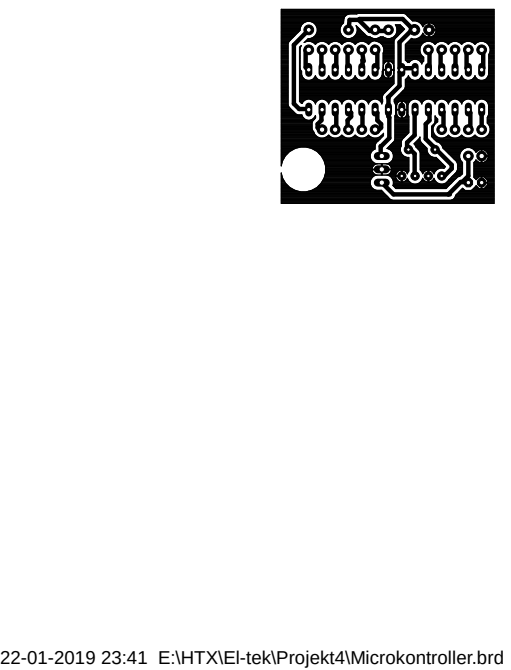
[picture p44: page 1]

22-01-2019 23:41 E:\HTX\El-tek\Projekt4\Microkontroller.brd
