Nikolaibonderup/P4---El-tek/El/Microkontroller.brd

## EAGLE design El/Microkontroller.brd (2019-01-28)

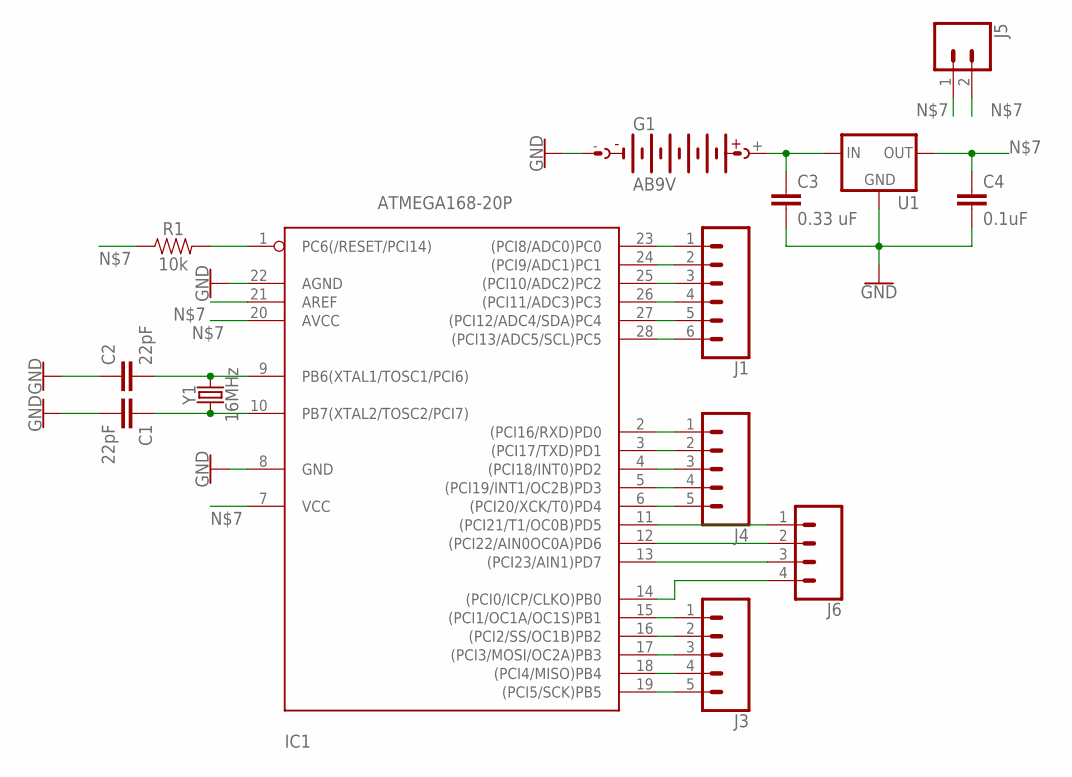
[picture p45: schematic Microkontroller.sch]

Parts:
C1, C2: 22pF; CAP-PTH-2.54
C3: 0.33 uF; C2.5-2
C4: 0.1uF; CAP-PTH-SMALL-KIT
G1: AB9V
IC1: ATMEGA168-20P; DIL28-3
J1: CONN_06SILK_FEMALE_PTH; 1X06
J3, J4: CONN_05; 1X05
J5: CONN_02; 1X02
J6: CONN_04; 1X04
R1: 10k; AXIAL-0.3
U1: V_REG_78XXSIDE; 78XXL
Y1: 16MHz; HC49US

Connections:
GND: C1.2, C2.1, C3.2, C4.2, G1.-, IC1.8 (GND), IC1.22 (AGND), U1.GND
unnamed: IC1.13 ((PCI23/AIN1)PD7), J6.3
unnamed: IC1.26 ((PCI11/ADC3)PC3), J1.4
unnamed: IC1.27 ((PCI12/ADC4/SDA)PC4), J1.5
unnamed: IC1.28 ((PCI13/ADC5/SCL)PC5), J1.6
unnamed: C2.2, IC1.9 (PB6(XTAL1/TOSC1/PCI6)), Y1.2
unnamed: C1.1, IC1.10 (PB7(XTAL2/TOSC2/PCI7)), Y1.1
unnamed: C4.1, IC1.7 (VCC), IC1.20 (AVCC), IC1.21 (AREF), J5.1, J5.2, R1.P$1 (1), U1.OUT
unnamed: IC1.1 (PC6(/RESET/PCI14)), R1.P$2 (2)
unnamed: C3.1, G1.+, U1.IN
unnamed: IC1.3 ((PCI17/TXD)PD1), J4.2
unnamed: IC1.2 ((PCI16/RXD)PD0), J4.1
unnamed: IC1.12 ((PCI22/AIN0OC0A)PD6), J6.2
unnamed: IC1.5 ((PCI19/INT1/OC2B)PD3), J4.4
unnamed: IC1.6 ((PCI20/XCK/T0)PD4), J4.5
unnamed: IC1.11 ((PCI21/T1/OC0B)PD5), J6.1
unnamed: IC1.4 ((PCI18/INT0)PD2), J4.3
unnamed: IC1.17 ((PCI3/MOSI/OC2A)PB3), J3.3
unnamed: IC1.18 ((PCI4/MISO)PB4), J3.4
unnamed: IC1.19 ((PCI5/SCK)PB5), J3.5
unnamed: IC1.14 ((PCI0/ICP/CLKO)PB0), J6.4
unnamed: IC1.15 ((PCI1/OC1A/OC1S)PB1), J3.1
unnamed: IC1.16 ((PCI2/SS/OC1B)PB2), J3.2
unnamed: IC1.25 ((PCI10/ADC2)PC2), J1.3
unnamed: IC1.24 ((PCI9/ADC1)PC1), J1.2
unnamed: IC1.23 ((PCI8/ADC0)PC0), J1.1

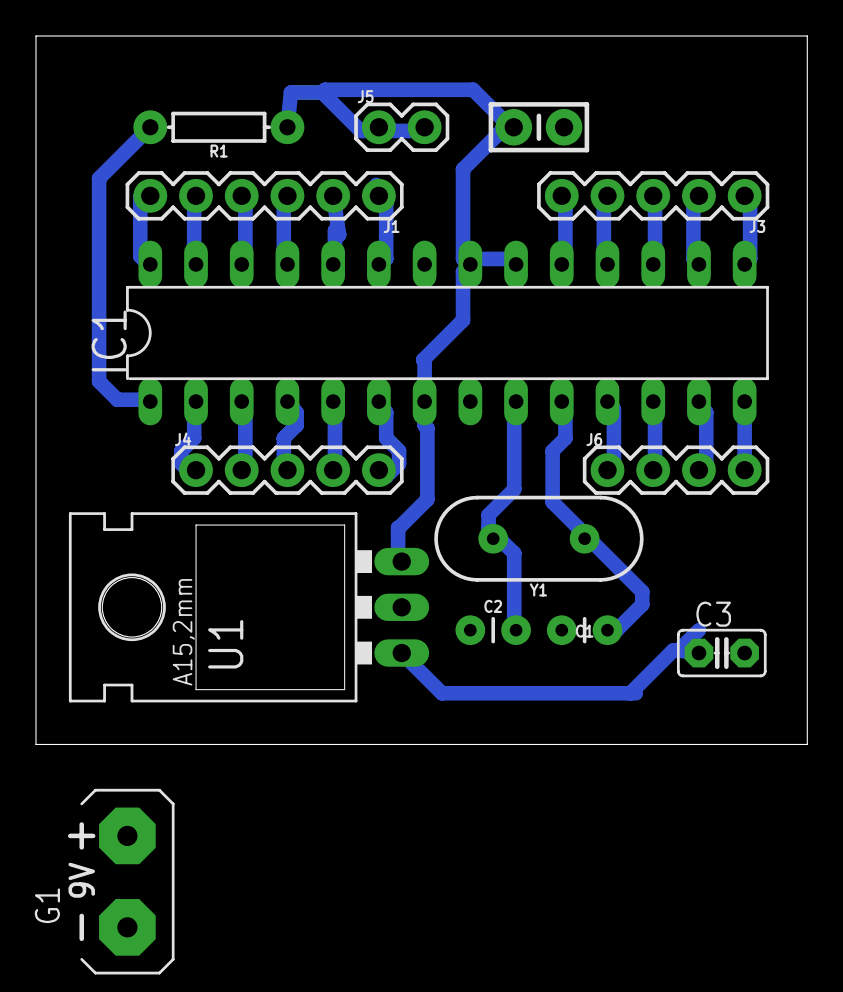
[picture p46: board Microkontroller.brd from above]

Board: 2 copper layers, 42.8 x 39.4 mm, 14 parts (0 on the bottom side), 26 nets.
