Nikolaibonderup/P4---El-tek/(commit log)

2019-01-23 El-diagram, PCB + billeder
    [Microkontroller.brd, Microkontroller.sch]
2019-01-23 Forbedret el-diagram + billede
2019-02-05 Billeder af print
2019-02-06 Færdiggjort rapport
    [Microkontroller.brd, Microkontroller.sch]
